MarkJelic/TEC-2014/Display/TEC-2014 Display (PCB Back).JPG

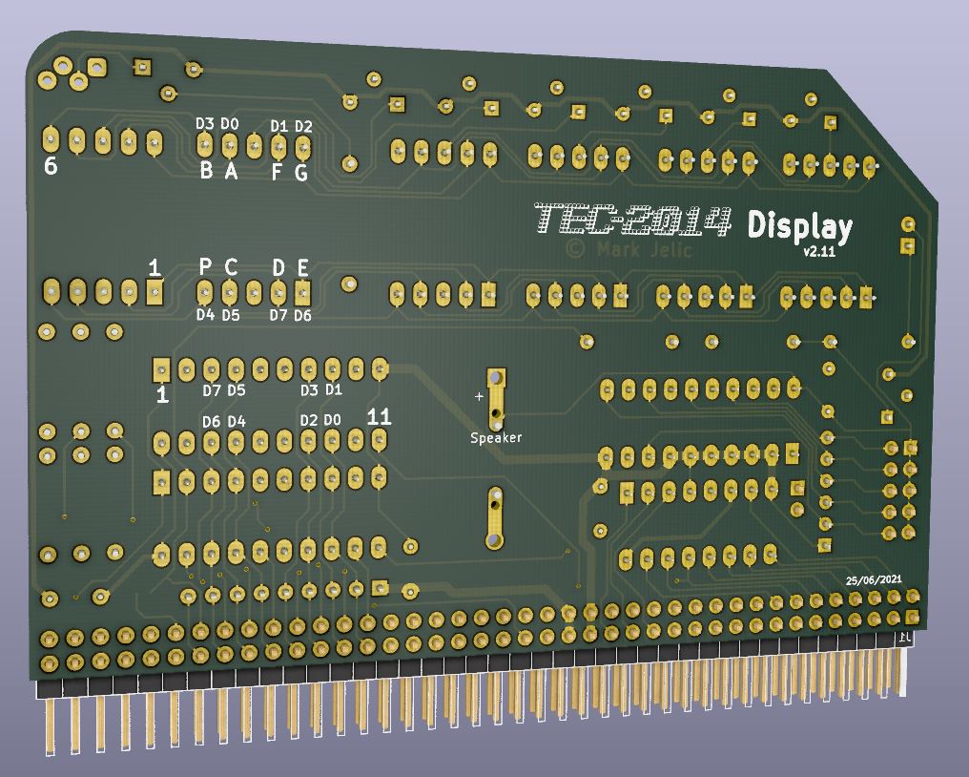
Display/TEC-2014 Display (PCB Back).JPG
