MarkJelic/TEC-2014/SBC/Readme.md

<h1>TEC-2014 Single Board Computer</h1>

Enclosed are all the design files (to date) for the SBC version of the TEC-2014
