MarkJelic/TEC-2014/Memory/Shadow ROM Memory Select Circuit Tester.txt

$ 0 0.000005 10.20027730826997 42 5 50 5e-11
154 -32 96 160 96 0 2 5 5
154 -32 224 160 224 0 2 0 5
154 -32 160 160 160 0 2 5 5
w -32 80 -112 80 0
w 160 192 160 160 0
L -624 -352 -688 -352 0 0 false 5 0
M 304 112 384 112 0 2.5
M 304 208 384 208 0 2.5
w -32 144 -48 144 0
w 160 160 160 128 0
w -112 160 -112 240 0
w -112 240 -32 240 0
w -48 112 -32 112 0
w -48 208 -32 208 0
w -48 144 -48 112 0
w -32 176 -48 176 0
w -48 176 -48 208 0
x -658 -389 -506 -386 4 24 Shadow\sLatch
x -528 356 -475 359 4 24 CS\s1
x -521 75 -468 78 4 24 CS\s8
L -528 -128 -672 -128 0 0 false 5 0
L -528 -96 -672 -96 0 0 false 5 0
x -726 -125 -686 -122 4 24 A11
x -733 -91 -691 -88 4 24 A12
w -112 80 -112 160 0
x -381 352 -283 355 4 24 16k\sRAM
x -419 49 -318 52 4 24 16k\sROM
L -576 -64 -672 -64 0 1 false 5 0
L -512 96 -560 96 0 1 false 5 0
w -176 112 -48 112 0
w -176 208 -48 208 0
155 -624 -352 -560 -352 0 0
x -733 -59 -691 -56 4 24 A13
x -732 -27 -690 -24 4 24 A14
x -733 5 -691 8 4 24 A15
L -608 -32 -672 -32 0 0 false 5 0
L -640 0 -672 0 0 0 false 5 0
w -256 0 -464 0 0
L -624 -320 -688 -320 0 0 false 5 0
184 -672 64 -624 64 3072 3
w -576 -64 -528 -64 0
w -608 -32 -528 -32 0
w -640 0 -528 0 0
151 -256 -16 -112 -16 0 2 0 5
151 160 112 304 112 0 2 0 5
x -519 -330 -404 -327 4 16 LO\s\q\sRom\s@\s2k
x -517 -266 -402 -263 4 16 LO\s\q\sRam\s@\s2k
M -672 320 -720 320 0 2.5
M -528 -352 -480 -352 0 2.5
M -528 -288 -480 -288 0 2.5
x -488 -390 -353 -387 4 16 (On\sReset,\sQ\s\q\sLo)
151 160 208 304 208 0 2 5 5
w -528 -352 -528 -160 0
L -512 128 -560 128 0 1 false 5 0
L -512 160 -560 160 0 1 false 5 0
L -512 192 -560 192 0 1 false 5 0
L -512 224 -560 224 0 1 false 5 0
L -512 256 -560 256 0 1 false 5 0
L -512 288 -560 288 0 0 false 5 0
L -512 320 -560 320 0 1 false 5 0
d -528 0 -464 0 2 default
d -528 -32 -464 -32 2 default
d -528 -64 -464 -64 2 default
d -528 -96 -464 -96 2 default
d -528 -128 -464 -128 2 default
d -528 -160 -464 -160 2 default
r -384 -160 -464 -160 0 10000
g -384 -160 -352 -160 0 0
w -256 0 -256 -32 0
w -576 32 -576 -64 0
w -608 32 -608 -32 0
w -640 32 -640 0 0
w -512 320 -352 320 0
w -512 288 -352 288 0
w -288 288 -288 320 0
w -176 320 -176 208 0
w -512 128 -352 128 0
w -512 96 -352 96 0
w -176 128 -176 112 0
x -434 77 -307 80 4 24 Start\s@\s48k
w -112 -16 -112 80 0
w -464 0 -464 -32 0
w -464 -32 -464 -64 0
w -464 -64 -464 -96 0
w -464 -96 -464 -128 0
w -464 -128 -464 -160 0
d -288 128 -352 128 2 default
d -288 96 -352 96 2 default
d -288 288 -352 288 2 default
d -288 320 -352 320 2 default
w -176 128 -288 128 0
w -288 320 -176 320 0
r -96 320 -176 320 0 10000
r -176 112 -176 64 0 10000
R -96 320 -48 320 0 0 40 5 0 0 0.5
R -176 64 -224 64 0 0 40 5 0 0 0.5
x 269 249 465 252 4 24 ROM\sSelect\s(Low)
x 272 87 465 90 4 24 RAM\sSelect\s(Low)
w -288 96 -288 128 0
