MarkJelic/TEC-2014/SBC/TEC-2014s Schematic.pdf

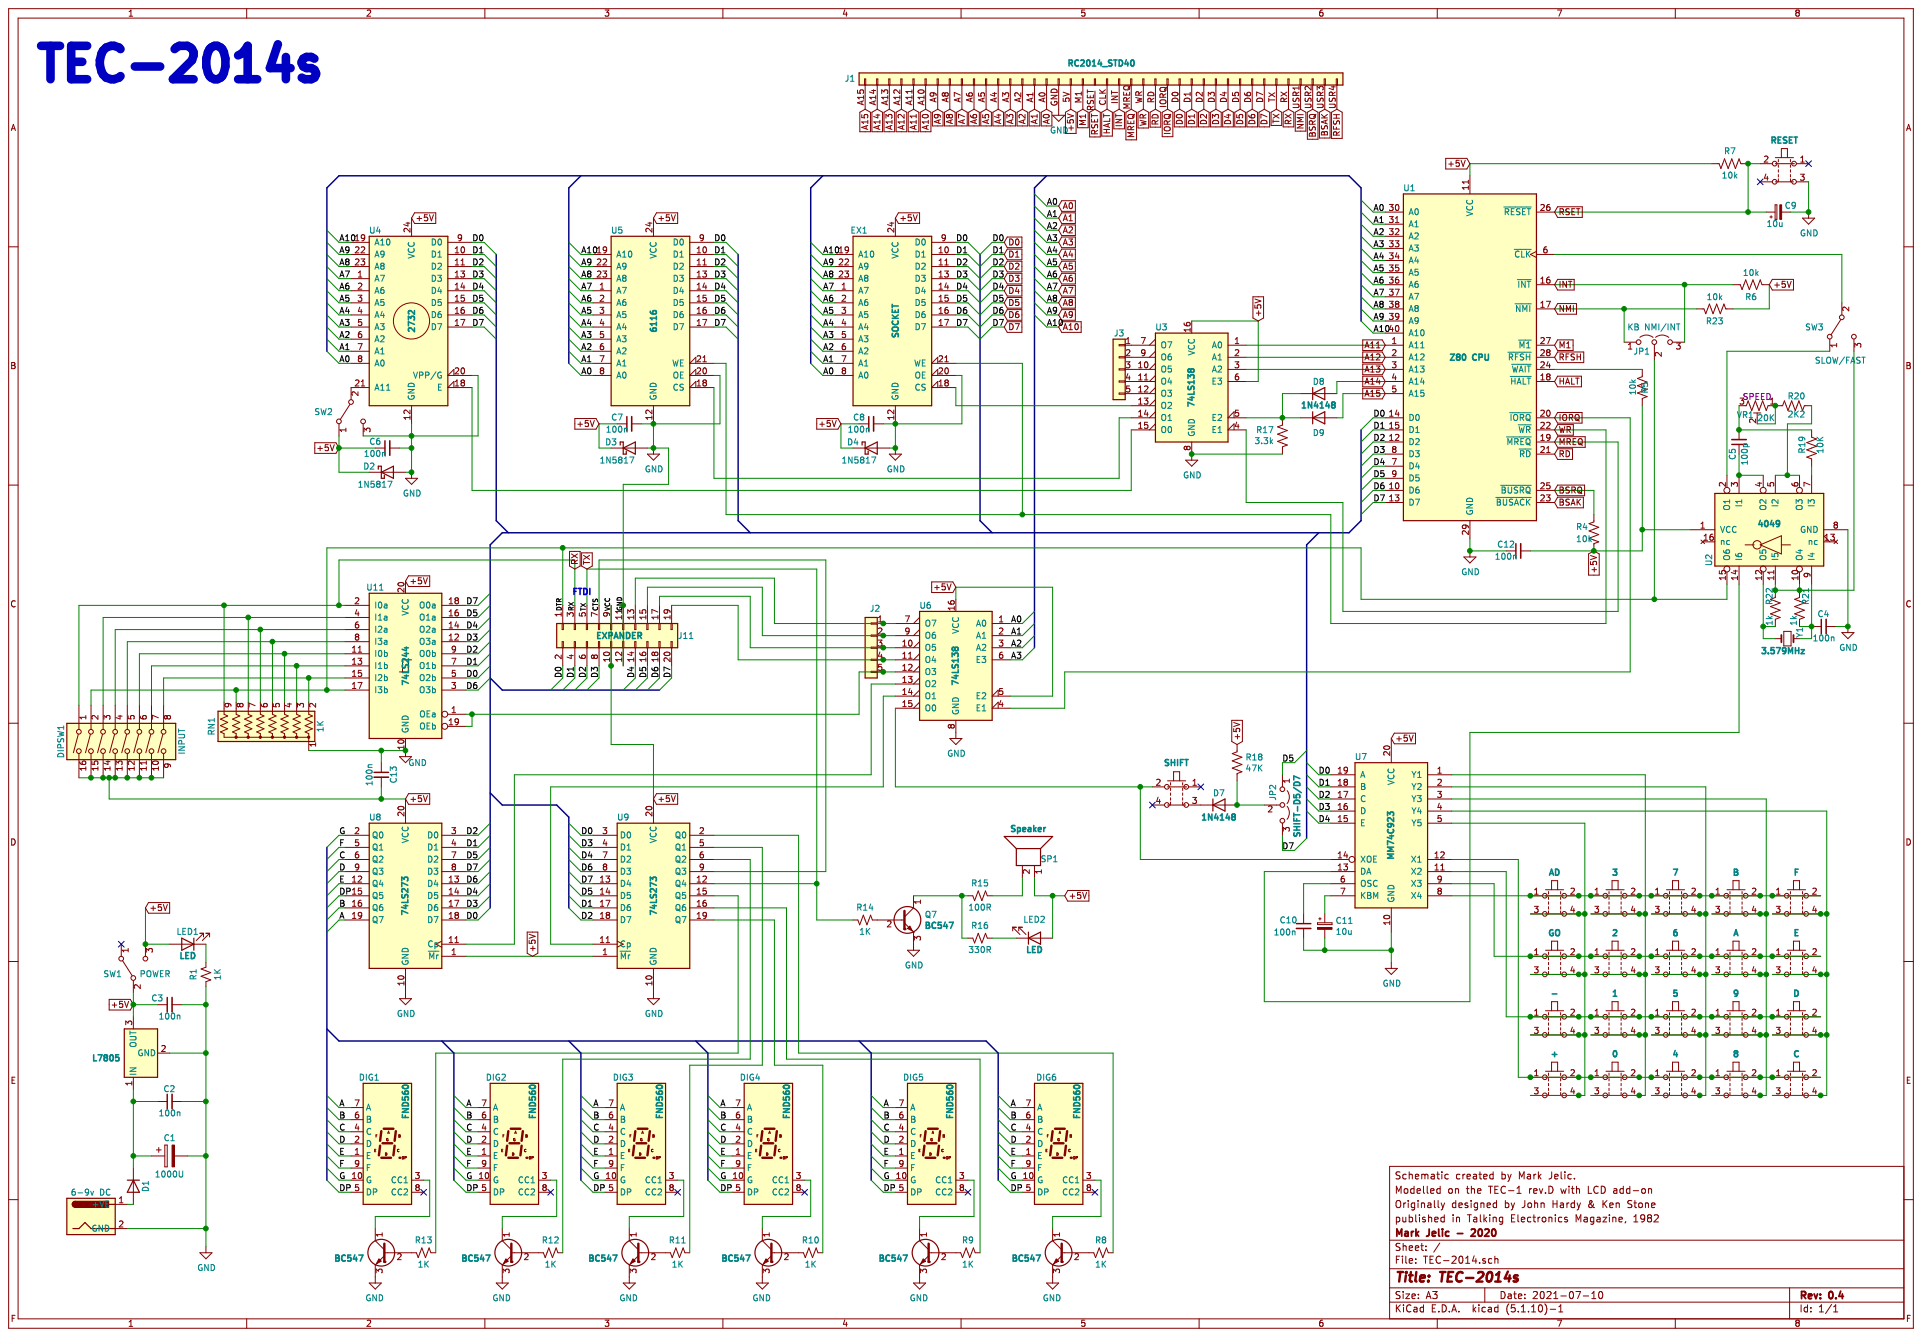
[picture p2: page 1]
