MarkJelic/TEC-2014/Display/TEC-2014 Display v2 Schematic.pdf

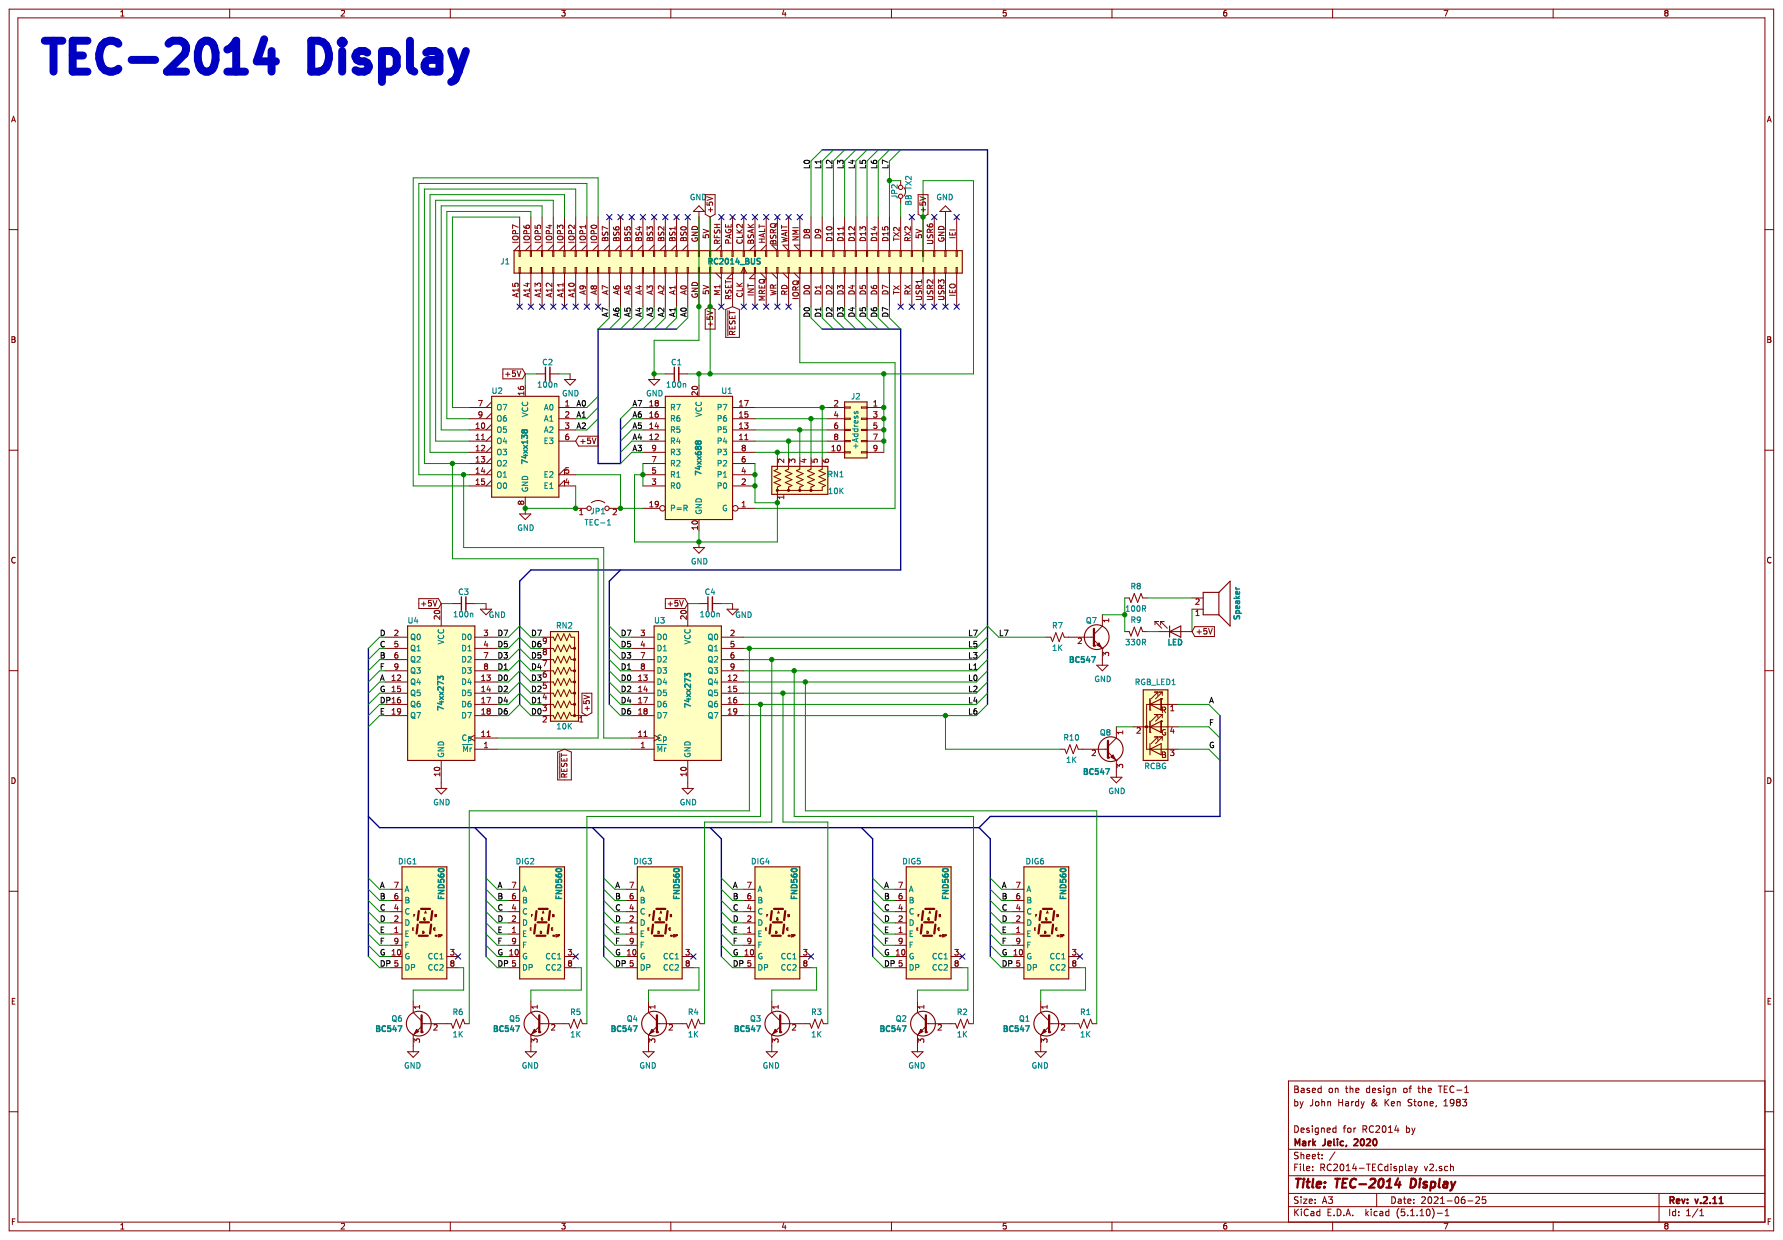
[picture p3: page 1]
