MarkJelic/TEC-2014/Memory/TEC-2014 Memory.pdf

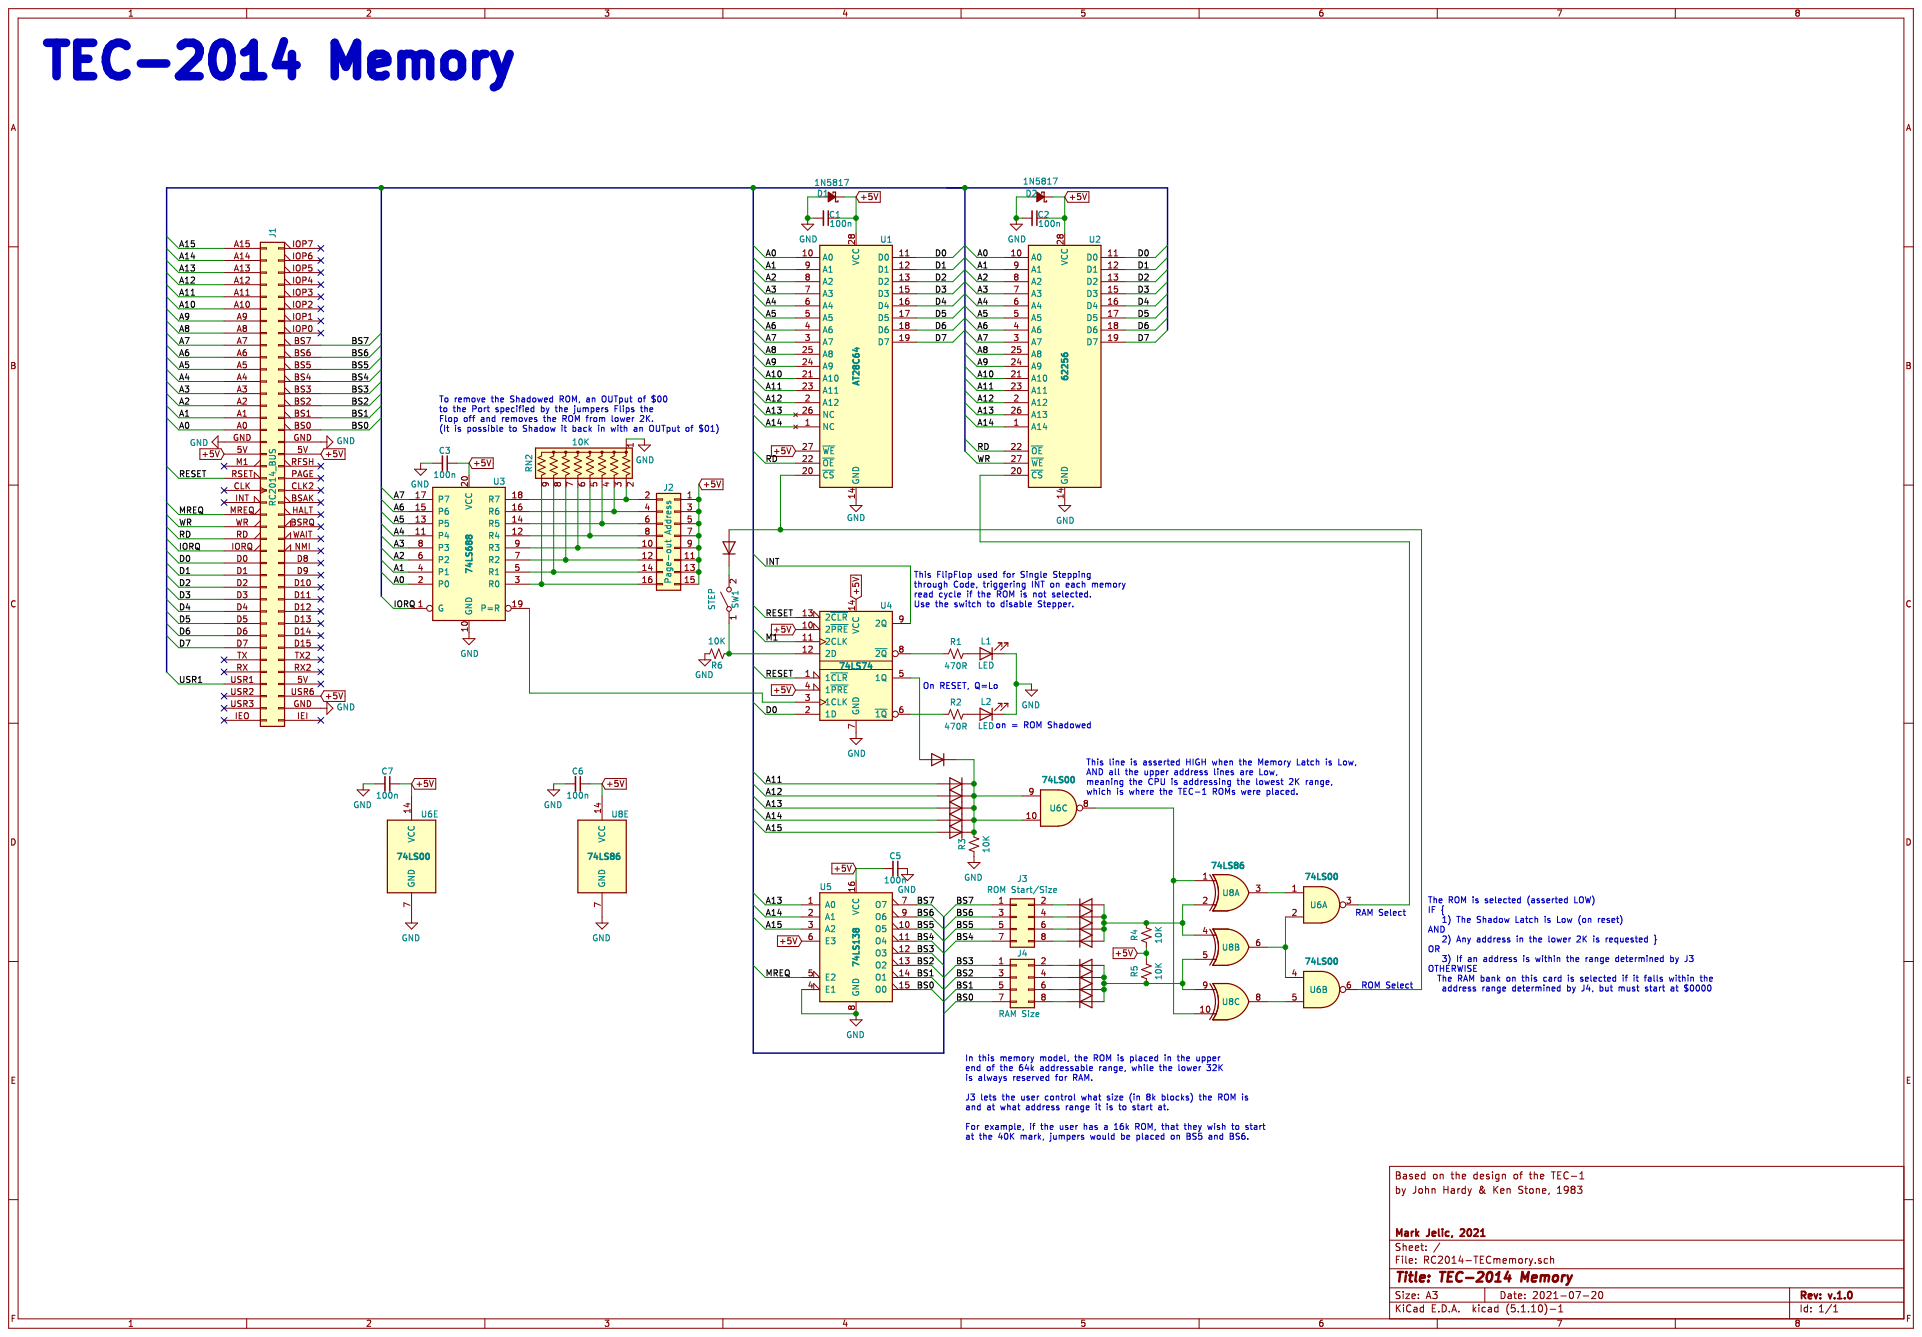
[picture p4: page 1]
