MarkJelic/TEC-2014/Keyboard/TEC-2014 Keyboard.pdf

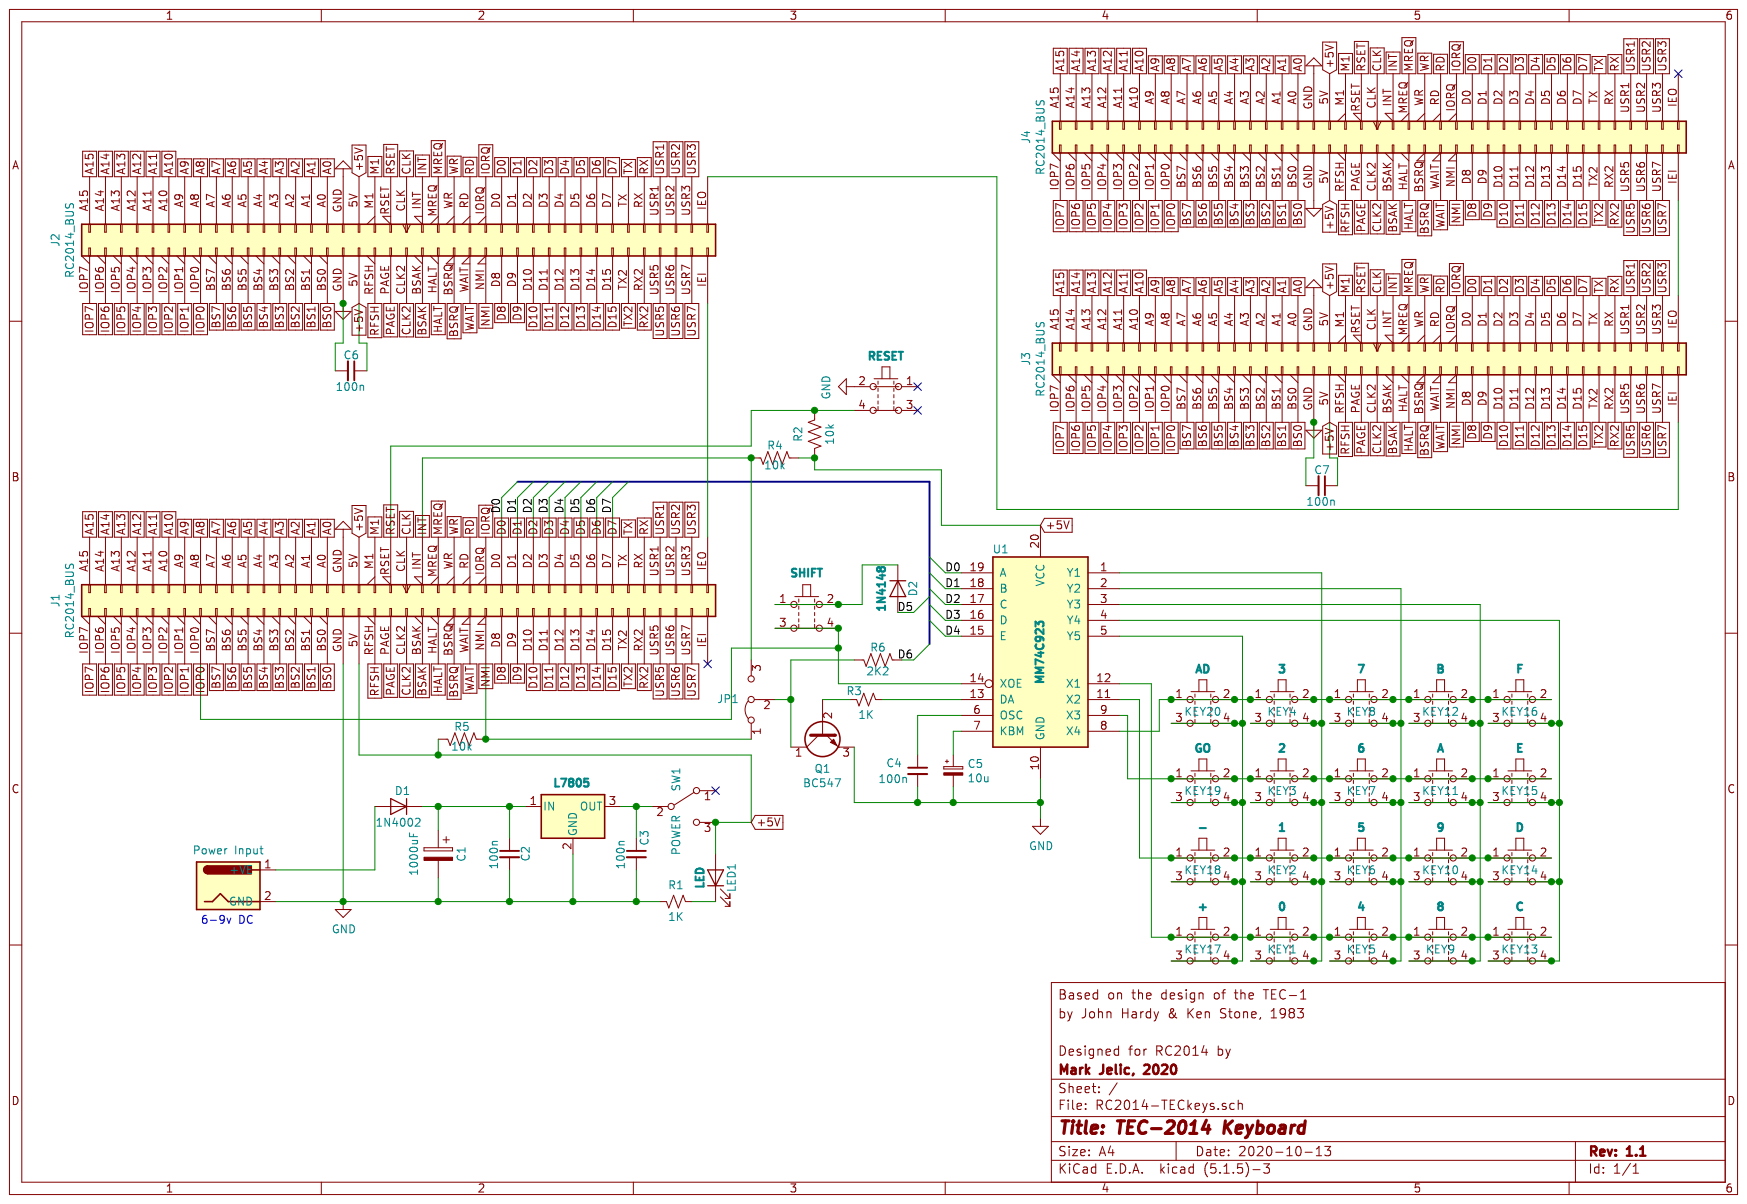
[picture p5: page 1]
