MarkJelic/TEC-2014/Display/RC2014-TECdisplay v2.sch

## KiCad design Display/RC2014-TECdisplay v2.sch (2021-07-03)

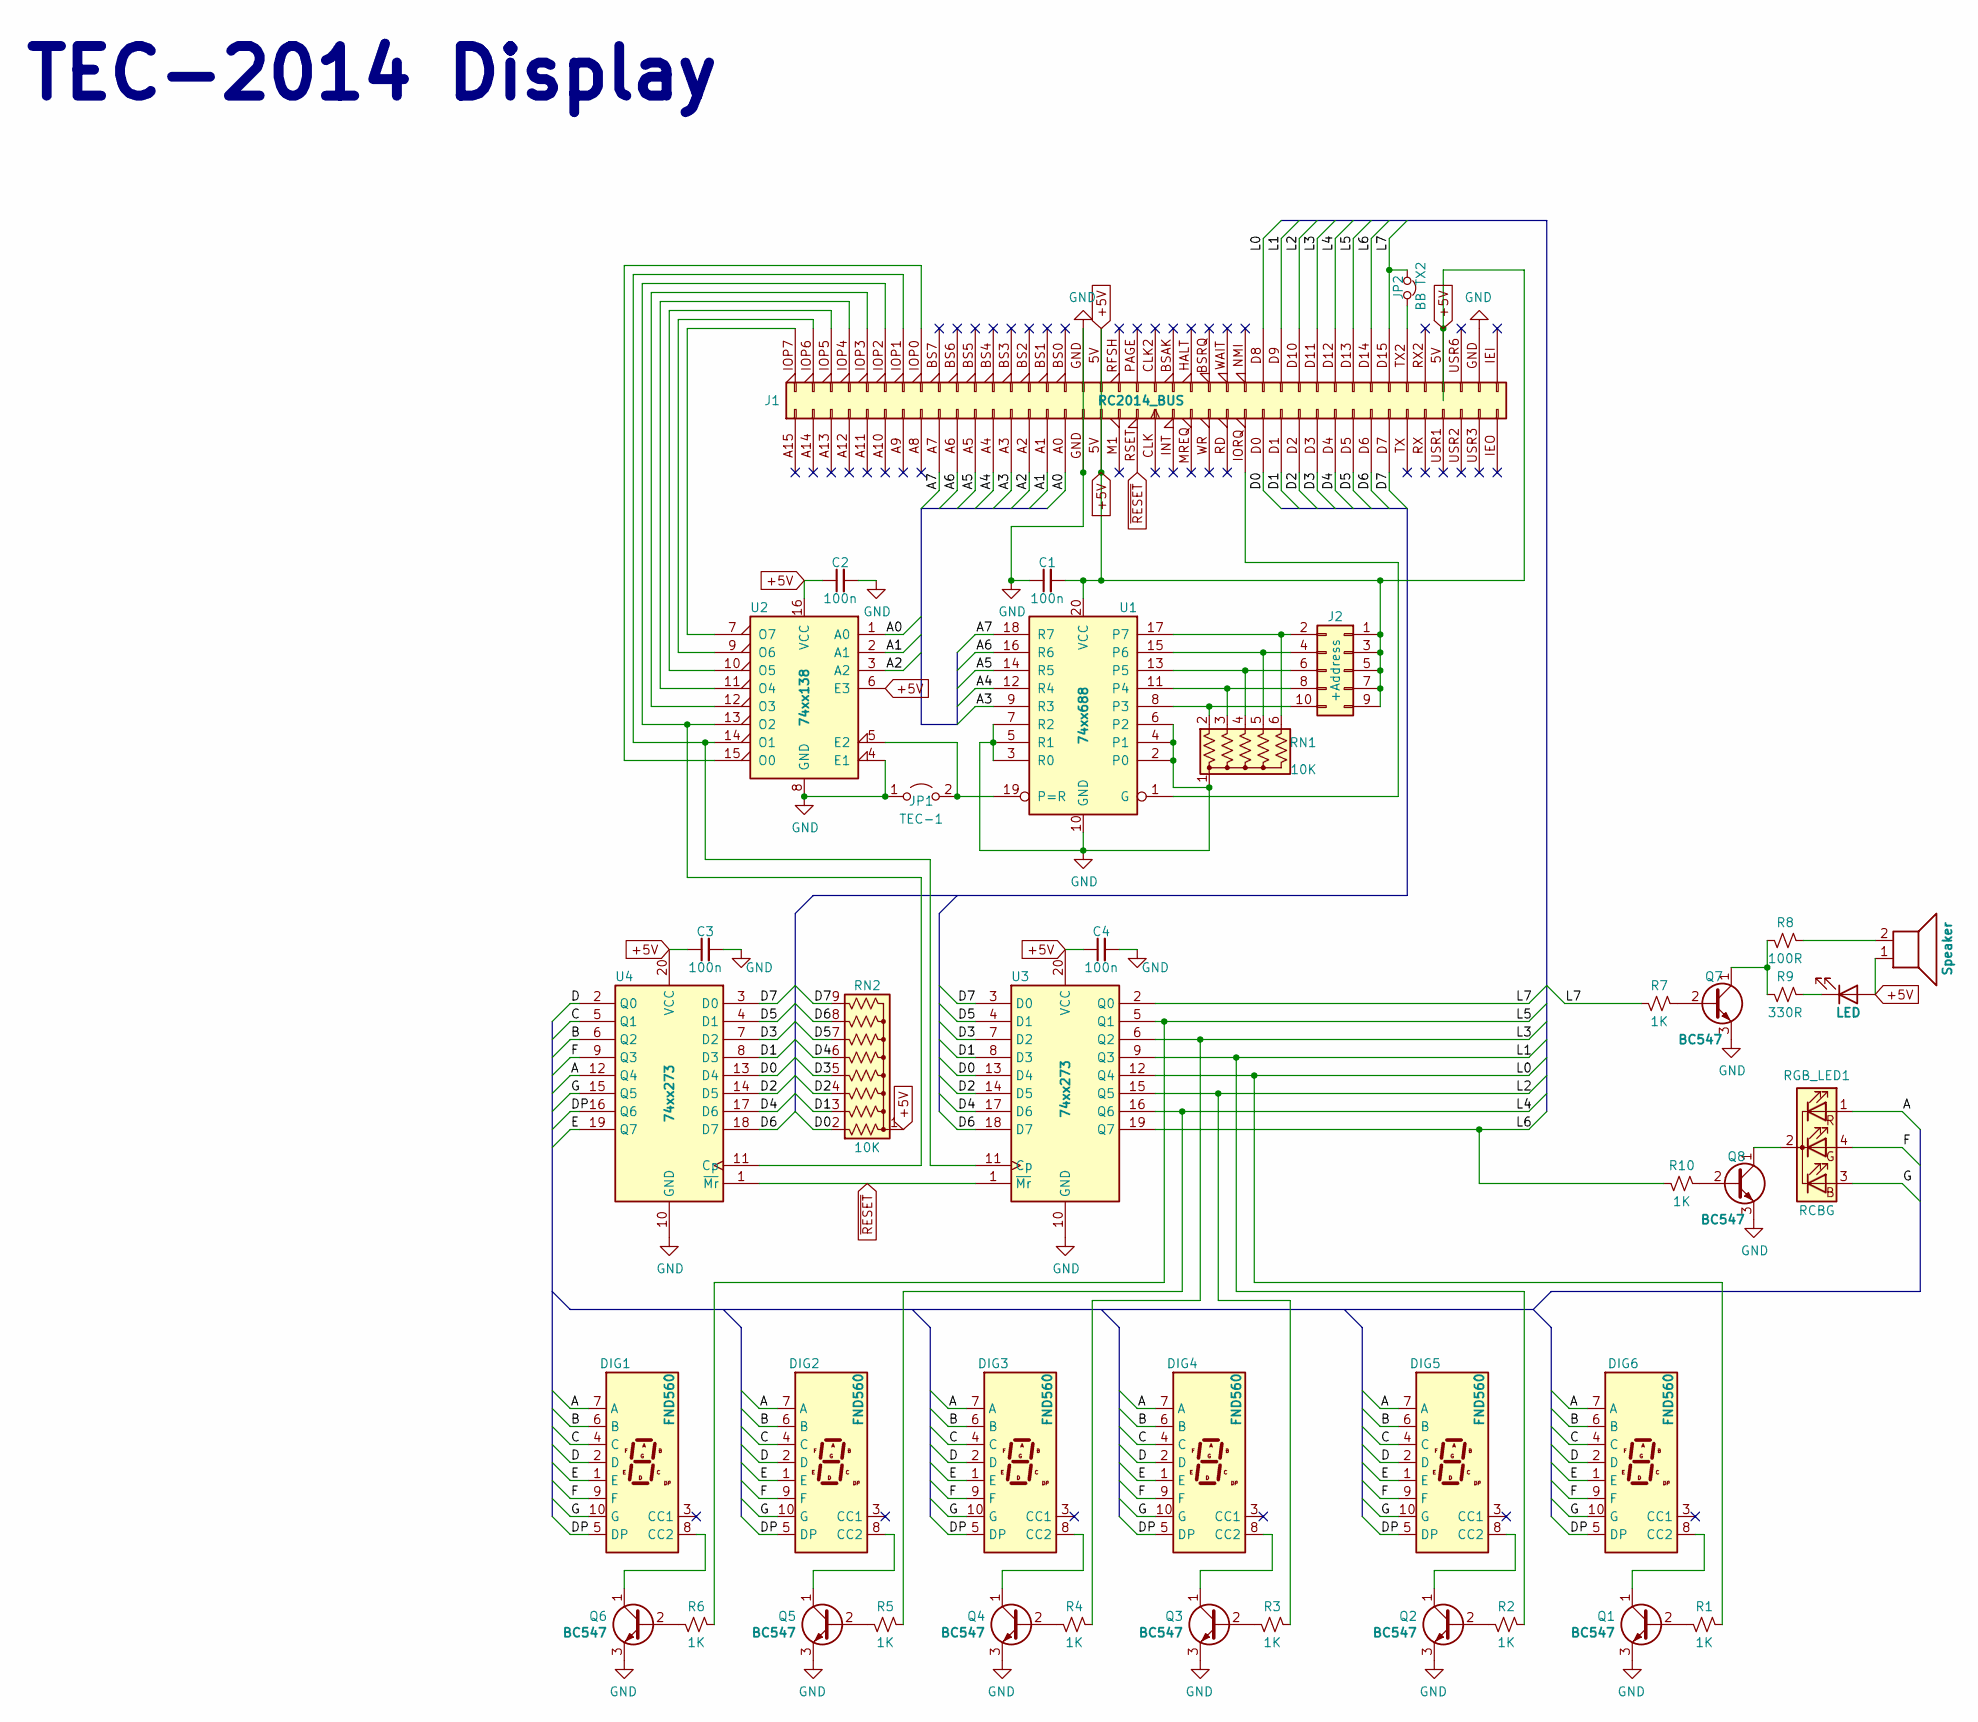
[picture p6: schematic RC2014-TECdisplay v2.sch]

Parts:
C1, C2, C3, C4: 100n; C_Disc_D6.0mm_W2.5mm_P5.00mm
D1: LED; LED_D5.0mm
DIG1, DIG2, DIG3, DIG4, DIG5, DIG6: FND560; 7SegmentLED_LTS6760_LTS6780
J1: RC2014_BUS; RC2014_PinHeader_Horizontal
J2: +Address; PinHeader_2x05_P2.54mm_Vertical
JP1: TEC-1; PinHeader_1x02_P2.54mm_Vertical
JP2: BB TX2; SolderJumper-2_P1.3mm_Bridged_RoundedPad1.0x1.5mm
Q1, Q2, Q3, Q4, Q5, Q6, Q7, Q8: BC547; TO-92L_Wide
R1, R2, R3, R4, R5, R6, R7, R10: 1K; R_Axial_DIN0207_L6.3mm_D2.5mm_P10.16mm_Horizontal
R8: 100R; R_Axial_DIN0207_L6.3mm_D2.5mm_P10.16mm_Horizontal
R9: 330R; R_Axial_DIN0207_L6.3mm_D2.5mm_P10.16mm_Horizontal
RGB_LED1: RCBG; LED_D5.0mm-4_RGB_Staggered_Pins
RN1: 10K; R_Array_SIP6
RN2: 10K; R_Array_SIP9
Speaker1: Speaker; MagneticBuzzer_ProSignal_ABI-010-RC
U1: 74xx688; DIP-20_W7.62mm_LongPads
U2: 74xx138; DIP-16_W7.62mm_LongPads
U3, U4: 74xx273; DIP-20_W7.62mm_LongPads

Connections:
+5V: C1.2, C2.1, C3.1, C4.1, D1.2 (A), J1.5V (Pin_18), J2.1, J2.3, J2.5, J2.7, J2.9, RN2.1 (common), Speaker1.1, U1.20 (VCC), U2.6 (E3), U2.16 (VCC), U3.20 (VCC), U4.20 (VCC)
A: DIG1.7 (A), DIG2.7 (A), DIG3.7 (A), DIG4.7 (A), DIG5.7 (A), DIG6.7 (A), RGB_LED1.1 (RA), U4.12 (Q4)
A0: J1.A0 (Pin_16), U2.1 (A0)
A1: J1.A1 (Pin_15), U2.2 (A1)
A2: J1.A2 (Pin_14), U2.3 (A2)
A3: J1.A3 (Pin_13), U1.9 (R3)
A4: J1.A4 (Pin_12), U1.12 (R4)
A5: J1.A5 (Pin_11), U1.14 (R5)
A6: J1.A6 (Pin_10), U1.16 (R6)
A7: J1.A7 (Pin_9), U1.18 (R7)
B: DIG1.6 (B), DIG2.6 (B), DIG3.6 (B), DIG4.6 (B), DIG5.6 (B), DIG6.6 (B), U4.6 (Q2)
C: DIG1.4 (C), DIG2.4 (C), DIG3.4 (C), DIG4.4 (C), DIG5.4 (C), DIG6.4 (C), U4.5 (Q1)
D: DIG1.2 (D), DIG2.2 (D), DIG3.2 (D), DIG4.2 (D), DIG5.2 (D), DIG6.2 (D), U4.2 (Q0)
D0: J1.D0 (Pin_27), RN2.2 (R1), U3.13 (D4), U4.13 (D4)
D1: J1.D1 (Pin_28), RN2.3 (R2), U3.8 (D3), U4.8 (D3)
D2: J1.D2 (Pin_29), RN2.4 (R3), U3.14 (D5), U4.14 (D5)
D3: J1.D3 (Pin_30), RN2.5 (R4), U3.7 (D2), U4.7 (D2)
D4: J1.D4 (Pin_31), RN2.6 (R5), U3.17 (D6), U4.17 (D6)
D5: J1.D5 (Pin_32), RN2.7 (R6), U3.4 (D1), U4.4 (D1)
D6: J1.D6 (Pin_33), RN2.8 (R7), U3.18 (D7), U4.18 (D7)
D7: J1.D7 (Pin_34), RN2.9 (R8), U3.3 (D0), U4.3 (D0)
DP: DIG1.5 (DP), DIG2.5 (DP), DIG3.5 (DP), DIG4.5 (DP), DIG5.5 (DP), DIG6.5 (DP), U4.16 (Q6)
E: DIG1.1 (E), DIG2.1 (E), DIG3.1 (E), DIG4.1 (E), DIG5.1 (E), DIG6.1 (E), U4.19 (Q7)
F: DIG1.9 (F), DIG2.9 (F), DIG3.9 (F), DIG4.9 (F), DIG5.9 (F), DIG6.9 (F), RGB_LED1.4 (GA), U4.9 (Q3)
G: DIG1.10 (G), DIG2.10 (G), DIG3.10 (G), DIG4.10 (G), DIG5.10 (G), DIG6.10 (G), RGB_LED1.3 (BA), U4.15 (Q5)
GND: C1.1, C2.2, C3.2, C4.2, J1.GND (Pin_17), JP1.1 (A), Q1.3 (E), Q2.3 (E), Q3.3 (E), Q4.3 (E), Q5.3 (E), Q6.3 (E), Q7.3 (E), Q8.3 (E), RN1.1 (common), U1.2 (P0), U1.3 (R0), U1.4 (P1), U1.5 (R1), U1.6 (P2), U1.7 (R2), U1.10 (GND), U2.4 (E1), U2.8 (GND), U3.10 (GND), U4.10 (GND)
L0: J1.D8 (Pin_67), R1.1, U3.12 (Q4)
L1: J1.D9 (Pin_68), R2.1, U3.9 (Q3)
L2: J1.D10 (Pin_69), R3.1, U3.15 (Q5)
L3: J1.D11 (Pin_70), R4.1, U3.6 (Q2)
L4: J1.D12 (Pin_71), R5.1, U3.16 (Q6)
L5: J1.D13 (Pin_72), R6.1, U3.5 (Q1)
L6: J1.D14 (Pin_73), R10.2, U3.19 (Q7)
L7: J1.D15 (Pin_74), JP2.1, R7.2, U3.2 (Q0)
unnamed: D1.1 (K), R9.1
unnamed: DIG1.8 (CC2), Q6.1 (C)
unnamed: DIG2.8 (CC2), Q5.1 (C)
unnamed: DIG3.8 (CC2), Q4.1 (C)
unnamed: DIG4.8 (CC2), Q3.1 (C)
unnamed: DIG5.8 (CC2), Q2.1 (C)
unnamed: DIG6.8 (CC2), Q1.1 (C)
unnamed: J1.IOP0 (Pin_48), U2.15 (O0)
unnamed: J1.IOP1 (Pin_47), U2.14 (O1), U3.11 (Cp)
unnamed: J1.IOP2 (Pin_46), U2.13 (O2), U4.11 (Cp)
unnamed: J1.IOP3 (Pin_45), U2.12 (O3)
unnamed: J1.IOP4 (Pin_44), U2.11 (O4)
unnamed: J1.IOP5 (Pin_43), U2.10 (O5)
unnamed: J1.IOP6 (Pin_42), U2.9 (O6)
unnamed: J1.IOP7 (Pin_41), U2.7 (O7)
unnamed: J1.IORQ (Pin_26), U1.1 (G)
unnamed: J1.TX2 (Pin_75), JP2.2
unnamed: J2.2, RN1.6 (R5), U1.17 (P7)
unnamed: J2.4, RN1.5 (R4), U1.15 (P6)
unnamed: J2.6, RN1.4 (R3), U1.13 (P5)
unnamed: J2.8, RN1.3 (R2), U1.11 (P4)
unnamed: J2.10, RN1.2 (R1), U1.8 (P3)
unnamed: JP1.2 (B), U1.19 (P=R), U2.5 (E2)
unnamed: Q1.2 (B), R1.2
unnamed: Q2.2 (B), R2.2
unnamed: Q3.2 (B), R3.2
unnamed: Q4.2 (B), R4.2
unnamed: Q5.2 (B), R5.2
unnamed: Q6.2 (B), R6.2
unnamed: Q7.1 (C), R8.2, R9.2
unnamed: Q7.2 (B), R7.1
unnamed: Q8.1 (C), RGB_LED1.2 (K)
unnamed: Q8.2 (B), R10.1
unnamed: R8.1, Speaker1.2
~RESET: J1.RSET (Pin_20), U3.1 (~Mr), U4.1 (~Mr)

Notes on the sheet:
TEC-2014 Display
