MarkJelic/TEC-2014/Keyboard/RC2014-TECkeys.sch

## KiCad design Keyboard/RC2014-TECkeys.sch (2021-07-12)

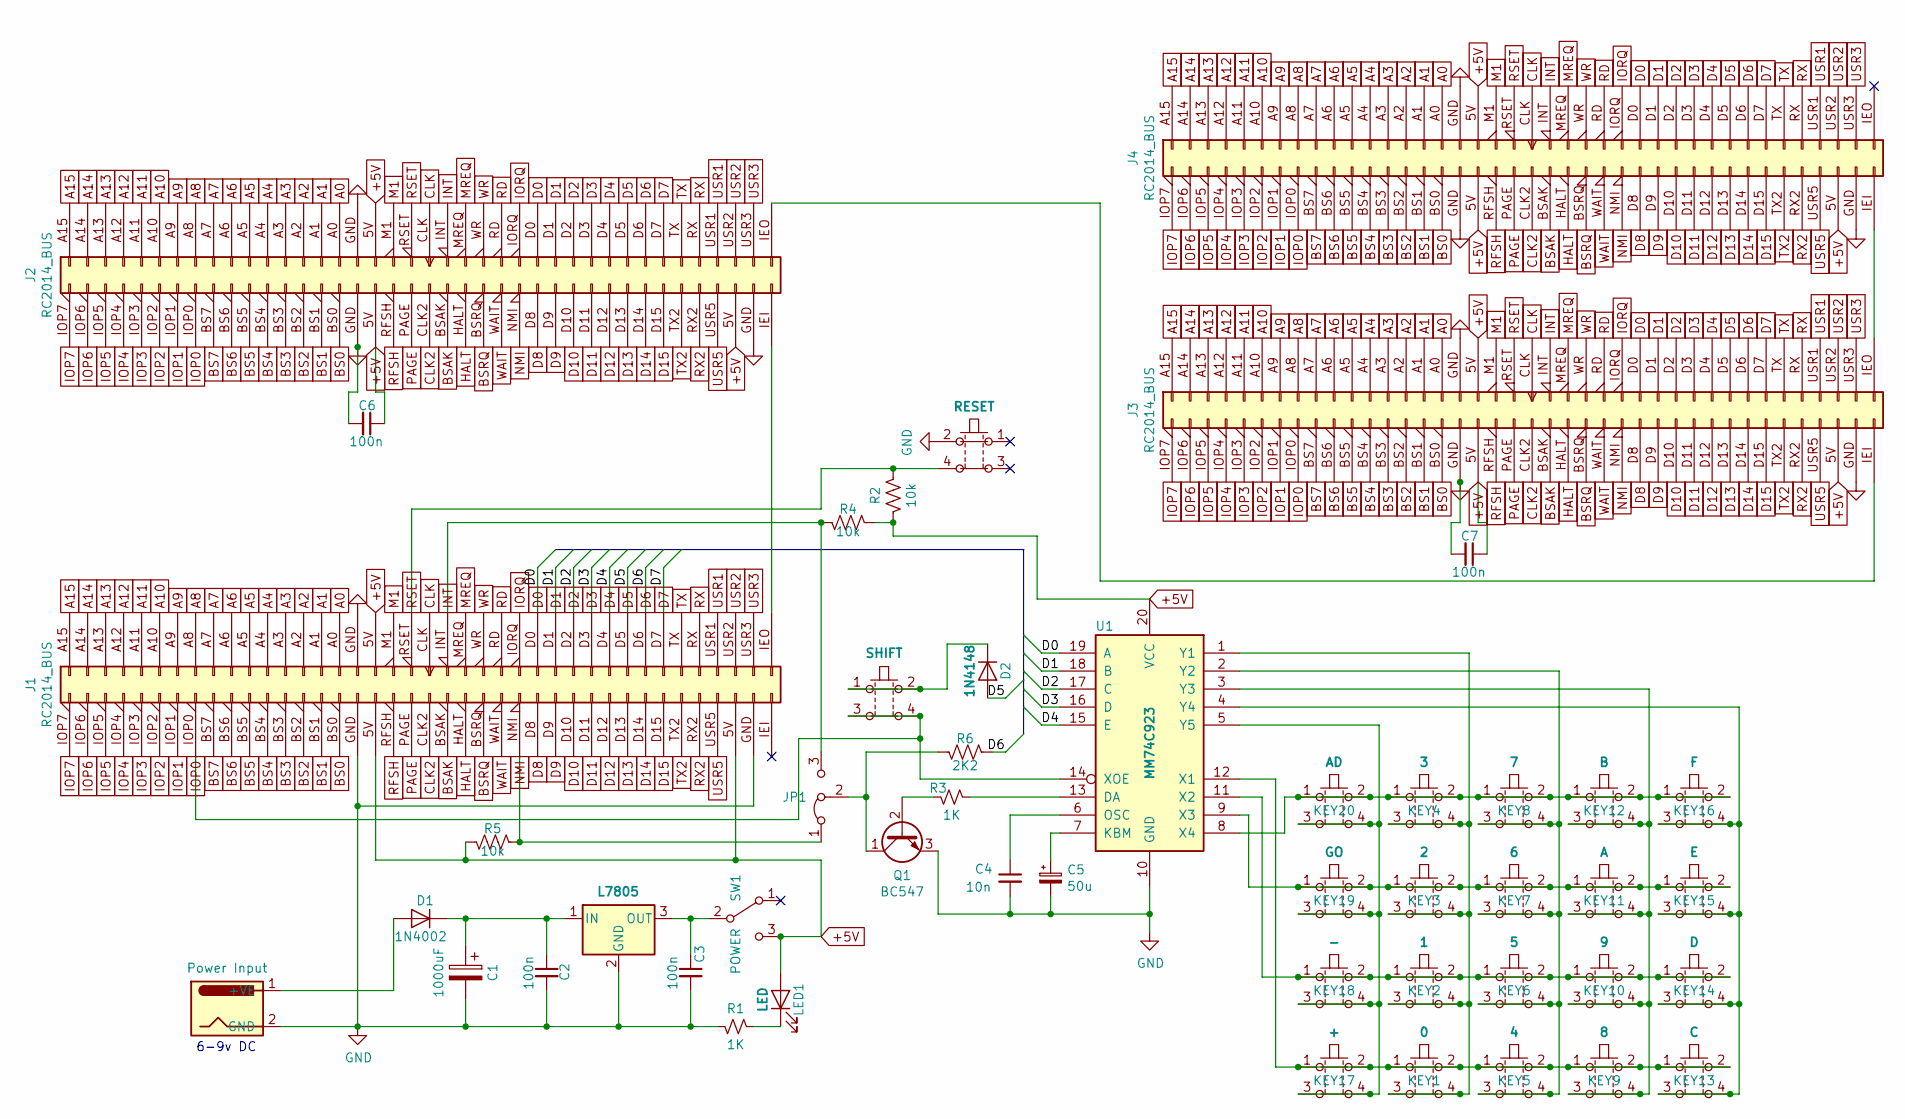
[picture p7: schematic RC2014-TECkeys.sch]

Parts:
C1: 1000uF; CP_Radial_D10.0mm_P5.00mm
C2, C3, C6, C7: 100n; C_Disc_D6.0mm_W2.5mm_P5.00mm
C4: 10n; C_Disc_D6.0mm_W2.5mm_P5.00mm
C5: 50u; CP_Radial_D5.0mm_P2.50mm
D1: 1N4002; D_DO-41_SOD81_P10.16mm_Horizontal
D2: 1N4148; D_DO-35_SOD27_P7.62mm_Horizontal
J1, J2, J3: RC2014_BUS; RC2014_PinSocket_Vertical
J4: RC2014_BUS; RC2014_PinSocket_Horizontal
JP1: NMI/INT; PinHeader_1x03_P2.54mm_Vertical
Jack1: Power Input; BarrelJack_Horizontal
KEY0: RESET; SW_Keyboard_6+12mm
KEY1: 0; SW_Keyboard_6+12mm
KEY2: 1; SW_Keyboard_6+12mm
KEY3: 2; SW_Keyboard_6+12mm
KEY4: 3; SW_Keyboard_6+12mm
KEY5: 4; SW_Keyboard_6+12mm
KEY6: 5; SW_Keyboard_6+12mm
KEY7: 6; SW_Keyboard_6+12mm
KEY8: 7; SW_Keyboard_6+12mm
KEY9: 8; SW_Keyboard_6+12mm
KEY10: 9; SW_Keyboard_6+12mm
KEY11: A; SW_Keyboard_6+12mm
KEY12: B; SW_Keyboard_6+12mm
KEY13: C; SW_Keyboard_6+12mm
KEY14: D; SW_Keyboard_6+12mm
KEY15: E; SW_Keyboard_6+12mm
KEY16: F; SW_Keyboard_6+12mm
KEY17: +; SW_Keyboard_6+12mm
KEY18: -; SW_Keyboard_6+12mm
KEY19: GO; SW_Keyboard_6+12mm
KEY20: AD; SW_Keyboard_6+12mm
KEY21: SHIFT; SW_Keyboard_6+12mm
LED1: LED; LED_D5.0mm
Q1: BC547; TO-92_HandSolder
R1, R3: 1K; R_Axial_DIN0207_L6.3mm_D2.5mm_P10.16mm_Horizontal
R2, R4, R5: 10k; R_Axial_DIN0207_L6.3mm_D2.5mm_P10.16mm_Horizontal
R6: 2K2; R_Axial_DIN0207_L6.3mm_D2.5mm_P10.16mm_Horizontal
REG1: L7805; 7805_Horizontal_TabDwn
SW1: POWER; SW_Slide
U1: MM74C923; DIP-20_W7.62mm_LongPads

Connections:
+5V: C6.1, C7.1, J1.5V (Pin_18), J2.5V (Pin_18), J3.5V (Pin_18), J4.5V (Pin_18), LED1.2 (A), R2.2, R4.1, R5.2, SW1.3 (C), U1.20 (VCC)
A0: J1.A0 (Pin_16), J2.A0 (Pin_16), J3.A0 (Pin_16), J4.A0 (Pin_16)
A1: J1.A1 (Pin_15), J2.A1 (Pin_15), J3.A1 (Pin_15), J4.A1 (Pin_15)
A2: J1.A2 (Pin_14), J2.A2 (Pin_14), J3.A2 (Pin_14), J4.A2 (Pin_14)
A3: J1.A3 (Pin_13), J2.A3 (Pin_13), J3.A3 (Pin_13), J4.A3 (Pin_13)
A4: J1.A4 (Pin_12), J2.A4 (Pin_12), J3.A4 (Pin_12), J4.A4 (Pin_12)
A5: J1.A5 (Pin_11), J2.A5 (Pin_11), J3.A5 (Pin_11), J4.A5 (Pin_11)
A6: J1.A6 (Pin_10), J2.A6 (Pin_10), J3.A6 (Pin_10), J4.A6 (Pin_10)
A7: J1.A7 (Pin_9), J2.A7 (Pin_9), J3.A7 (Pin_9), J4.A7 (Pin_9)
A8: J1.A8 (Pin_8), J2.A8 (Pin_8), J3.A8 (Pin_8), J4.A8 (Pin_8)
A9: J1.A9 (Pin_7), J2.A9 (Pin_7), J3.A9 (Pin_7), J4.A9 (Pin_7)
A10: J1.A10 (Pin_6), J2.A10 (Pin_6), J3.A10 (Pin_6), J4.A10 (Pin_6)
A11: J1.A11 (Pin_5), J2.A11 (Pin_5), J3.A11 (Pin_5), J4.A11 (Pin_5)
A12: J1.A12 (Pin_4), J2.A12 (Pin_4), J3.A12 (Pin_4), J4.A12 (Pin_4)
A13: J1.A13 (Pin_3), J2.A13 (Pin_3), J3.A13 (Pin_3), J4.A13 (Pin_3)
A14: J1.A14 (Pin_2), J2.A14 (Pin_2), J3.A14 (Pin_2), J4.A14 (Pin_2)
A15: J1.A15 (Pin_1), J2.A15 (Pin_1), J3.A15 (Pin_1), J4.A15 (Pin_1)
BS0: J1.BS0 (Pin_56), J2.BS0 (Pin_56), J3.BS0 (Pin_56), J4.BS0 (Pin_56)
BS1: J1.BS1 (Pin_55), J2.BS1 (Pin_55), J3.BS1 (Pin_55), J4.BS1 (Pin_55)
BS2: J1.BS2 (Pin_54), J2.BS2 (Pin_54), J3.BS2 (Pin_54), J4.BS2 (Pin_54)
BS3: J1.BS3 (Pin_53), J2.BS3 (Pin_53), J3.BS3 (Pin_53), J4.BS3 (Pin_53)
BS4: J1.BS4 (Pin_52), J2.BS4 (Pin_52), J3.BS4 (Pin_52), J4.BS4 (Pin_52)
BS5: J1.BS5 (Pin_51), J2.BS5 (Pin_51), J3.BS5 (Pin_51), J4.BS5 (Pin_51)
BS6: J1.BS6 (Pin_50), J2.BS6 (Pin_50), J3.BS6 (Pin_50), J4.BS6 (Pin_50)
BS7: J1.BS7 (Pin_49), J2.BS7 (Pin_49), J3.BS7 (Pin_49), J4.BS7 (Pin_49)
BSAK: J1.BSAK (Pin_62), J2.BSAK (Pin_62), J3.BSAK (Pin_62), J4.BSAK (Pin_62)
BSRQ: J1.BSRQ (Pin_64), J2.BSRQ (Pin_64), J3.BSRQ (Pin_64), J4.BSRQ (Pin_64)
CLK: J1.CLK (Pin_21), J2.CLK (Pin_21), J3.CLK (Pin_21), J4.CLK (Pin_21)
CLK2: J1.CLK2 (Pin_61), J2.CLK2 (Pin_61), J3.CLK2 (Pin_61), J4.CLK2 (Pin_61)
D0: J1.D0 (Pin_27), J2.D0 (Pin_27), J3.D0 (Pin_27), J4.D0 (Pin_27), U1.19 (A)
D1: J1.D1 (Pin_28), J2.D1 (Pin_28), J3.D1 (Pin_28), J4.D1 (Pin_28), U1.18 (B)
D2: J1.D2 (Pin_29), J2.D2 (Pin_29), J3.D2 (Pin_29), J4.D2 (Pin_29), U1.17 (C)
D3: J1.D3 (Pin_30), J2.D3 (Pin_30), J3.D3 (Pin_30), J4.D3 (Pin_30), U1.16 (D)
D4: J1.D4 (Pin_31), J2.D4 (Pin_31), J3.D4 (Pin_31), J4.D4 (Pin_31), U1.15 (E)
D5: D2.2 (A), J1.D5 (Pin_32), J2.D5 (Pin_32), J3.D5 (Pin_32), J4.D5 (Pin_32)
D6: J1.D6 (Pin_33), J2.D6 (Pin_33), J3.D6 (Pin_33), J4.D6 (Pin_33), R6.1
D7: J1.D7 (Pin_34), J2.D7 (Pin_34), J3.D7 (Pin_34), J4.D7 (Pin_34)
D8: J1.D8 (Pin_67), J2.D8 (Pin_67), J3.D8 (Pin_67), J4.D8 (Pin_67)
D9: J1.D9 (Pin_68), J2.D9 (Pin_68), J3.D9 (Pin_68), J4.D9 (Pin_68)
D10: J1.D10 (Pin_69), J2.D10 (Pin_69), J3.D10 (Pin_69), J4.D10 (Pin_69)
D11: J1.D11 (Pin_70), J2.D11 (Pin_70), J3.D11 (Pin_70), J4.D11 (Pin_70)
D12: J1.D12 (Pin_71), J2.D12 (Pin_71), J3.D12 (Pin_71), J4.D12 (Pin_71)
D13: J1.D13 (Pin_72), J2.D13 (Pin_72), J3.D13 (Pin_72), J4.D13 (Pin_72)
D14: J1.D14 (Pin_73), J2.D14 (Pin_73), J3.D14 (Pin_73), J4.D14 (Pin_73)
D15: J1.D15 (Pin_74), J2.D15 (Pin_74), J3.D15 (Pin_74), J4.D15 (Pin_74)
GND: C1.2, C2.2, C3.2, C4.2, C5.2, C6.2, C7.2, J1.GND (Pin_17), J2.GND (Pin_17), J3.GND (Pin_17), J4.GND (Pin_17), Jack1.2 (GND), KEY0.2, Q1.3 (E), R1.2, REG1.2 (GND), U1.10 (GND)
HALT: J1.HALT (Pin_63), J2.HALT (Pin_63), J3.HALT (Pin_63), J4.HALT (Pin_63)
INT: J1.INT (Pin_22), J2.INT (Pin_22), J3.INT (Pin_22), J4.INT (Pin_22), JP1.3 (B), R4.2
IOP0: J1.IOP0 (Pin_48), J2.IOP0 (Pin_48), J3.IOP0 (Pin_48), J4.IOP0 (Pin_48), KEY21.3, KEY21.4, U1.14 (XOE)
IOP1: J1.IOP1 (Pin_47), J2.IOP1 (Pin_47), J3.IOP1 (Pin_47), J4.IOP1 (Pin_47)
IOP2: J1.IOP2 (Pin_46), J2.IOP2 (Pin_46), J3.IOP2 (Pin_46), J4.IOP2 (Pin_46)
IOP3: J1.IOP3 (Pin_45), J2.IOP3 (Pin_45), J3.IOP3 (Pin_45), J4.IOP3 (Pin_45)
IOP4: J1.IOP4 (Pin_44), J2.IOP4 (Pin_44), J3.IOP4 (Pin_44), J4.IOP4 (Pin_44)
IOP5: J1.IOP5 (Pin_43), J2.IOP5 (Pin_43), J3.IOP5 (Pin_43), J4.IOP5 (Pin_43)
IOP6: J1.IOP6 (Pin_42), J2.IOP6 (Pin_42), J3.IOP6 (Pin_42), J4.IOP6 (Pin_42)
IOP7: J1.IOP7 (Pin_41), J2.IOP7 (Pin_41), J3.IOP7 (Pin_41), J4.IOP7 (Pin_41)
IORQ: J1.IORQ (Pin_26), J2.IORQ (Pin_26), J3.IORQ (Pin_26), J4.IORQ (Pin_26)
M1: J1.M1 (Pin_19), J2.M1 (Pin_19), J3.M1 (Pin_19), J4.M1 (Pin_19)
MREQ: J1.MREQ (Pin_23), J2.MREQ (Pin_23), J3.MREQ (Pin_23), J4.MREQ (Pin_23)
NMI: J1.NMI (Pin_66), J2.NMI (Pin_66), J3.NMI (Pin_66), J4.NMI (Pin_66), JP1.1 (A), R5.1
unnamed: C1.1, C2.1, D1.1 (K), REG1.1 (IN)
unnamed: C3.1, REG1.3 (OUT), SW1.2 (B)
unnamed: C4.1, U1.6 (OSC)
unnamed: C5.1, U1.7 (KBM)
unnamed: D1.2 (A), Jack1.1 (+VE)
unnamed: D2.1 (K), KEY21.1, KEY21.2
unnamed: J1.IEO (Pin_40), J2.IEI (Pin_80)
unnamed: J2.IEO (Pin_40), J3.IEI (Pin_80)
unnamed: J3.IEO (Pin_40), J4.IEI (Pin_80)
unnamed: JP1.2 (C), Q1.1 (C), R6.2
unnamed: KEY1.1, KEY1.2, KEY5.1, KEY5.2, KEY9.1, KEY9.2, KEY13.1, KEY13.2, KEY17.1, KEY17.2, U1.12 (X1)
unnamed: KEY1.3, KEY1.4, KEY2.3, KEY2.4, KEY3.3, KEY3.4, KEY4.3, KEY4.4, U1.1 (Y1)
unnamed: KEY5.3, KEY5.4, KEY6.3, KEY6.4, KEY7.3, KEY7.4, KEY8.3, KEY8.4, U1.2 (Y2)
unnamed: KEY2.1, KEY2.2, KEY6.1, KEY6.2, KEY10.1, KEY10.2, KEY14.1, KEY14.2, KEY18.1, KEY18.2, U1.11 (X2)
unnamed: KEY9.3, KEY9.4, KEY10.3, KEY10.4, KEY11.3, KEY11.4, KEY12.3, KEY12.4, U1.3 (Y3)
unnamed: KEY3.1, KEY3.2, KEY7.1, KEY7.2, KEY11.1, KEY11.2, KEY15.1, KEY15.2, KEY19.1, KEY19.2, U1.9 (X3)
unnamed: KEY4.1, KEY4.2, KEY8.1, KEY8.2, KEY12.1, KEY12.2, KEY16.1, KEY16.2, KEY20.1, KEY20.2, U1.8 (X4)
unnamed: KEY13.3, KEY13.4, KEY14.3, KEY14.4, KEY15.3, KEY15.4, KEY16.3, KEY16.4, U1.4 (Y4)
unnamed: KEY17.3, KEY17.4, KEY18.3, KEY18.4, KEY19.3, KEY19.4, KEY20.3, KEY20.4, U1.5 (Y5)
unnamed: LED1.1 (K), R1.1
unnamed: Q1.2 (B), R3.2
unnamed: R3.1, U1.13 (DA)
PAGE: J1.PAGE (Pin_60), J2.PAGE (Pin_60), J3.PAGE (Pin_60), J4.PAGE (Pin_60)
RD: J1.RD (Pin_25), J2.RD (Pin_25), J3.RD (Pin_25), J4.RD (Pin_25)
RFSH: J1.RFSH (Pin_59), J2.RFSH (Pin_59), J3.RFSH (Pin_59), J4.RFSH (Pin_59)
RSET: J1.RSET (Pin_20), J2.RSET (Pin_20), J3.RSET (Pin_20), J4.RSET (Pin_20), KEY0.4, R2.1
RX: J1.RX (Pin_36), J2.RX (Pin_36), J3.RX (Pin_36), J4.RX (Pin_36)
RX2: J1.RX2 (Pin_76), J2.RX2 (Pin_76), J3.RX2 (Pin_76), J4.RX2 (Pin_76)
TX: J1.TX (Pin_35), J2.TX (Pin_35), J3.TX (Pin_35), J4.TX (Pin_35)
TX2: J1.TX2 (Pin_75), J2.TX2 (Pin_75), J3.TX2 (Pin_75), J4.TX2 (Pin_75)
USR1: J1.USR1 (Pin_37), J2.USR1 (Pin_37), J3.USR1 (Pin_37), J4.USR1 (Pin_37)
USR2: J1.USR2 (Pin_38), J2.USR2 (Pin_38), J3.USR2 (Pin_38), J4.USR2 (Pin_38)
USR3: J1.USR3 (Pin_39), J2.USR3 (Pin_39), J3.USR3 (Pin_39), J4.USR3 (Pin_39)
USR5: J1.USR5 (Pin_77), J2.USR5 (Pin_77), J3.USR5 (Pin_77), J4.USR5 (Pin_77)
WAIT: J1.WAIT (Pin_65), J2.WAIT (Pin_65), J3.WAIT (Pin_65), J4.WAIT (Pin_65)
WR: J1.WR (Pin_24), J2.WR (Pin_24), J3.WR (Pin_24), J4.WR (Pin_24)

Notes on the sheet:
6-9v DC
