MarkJelic/TEC-2014/Memory/RC2014-TECmemory.sch

## KiCad design Memory/RC2014-TECmemory.sch (2021-07-20)

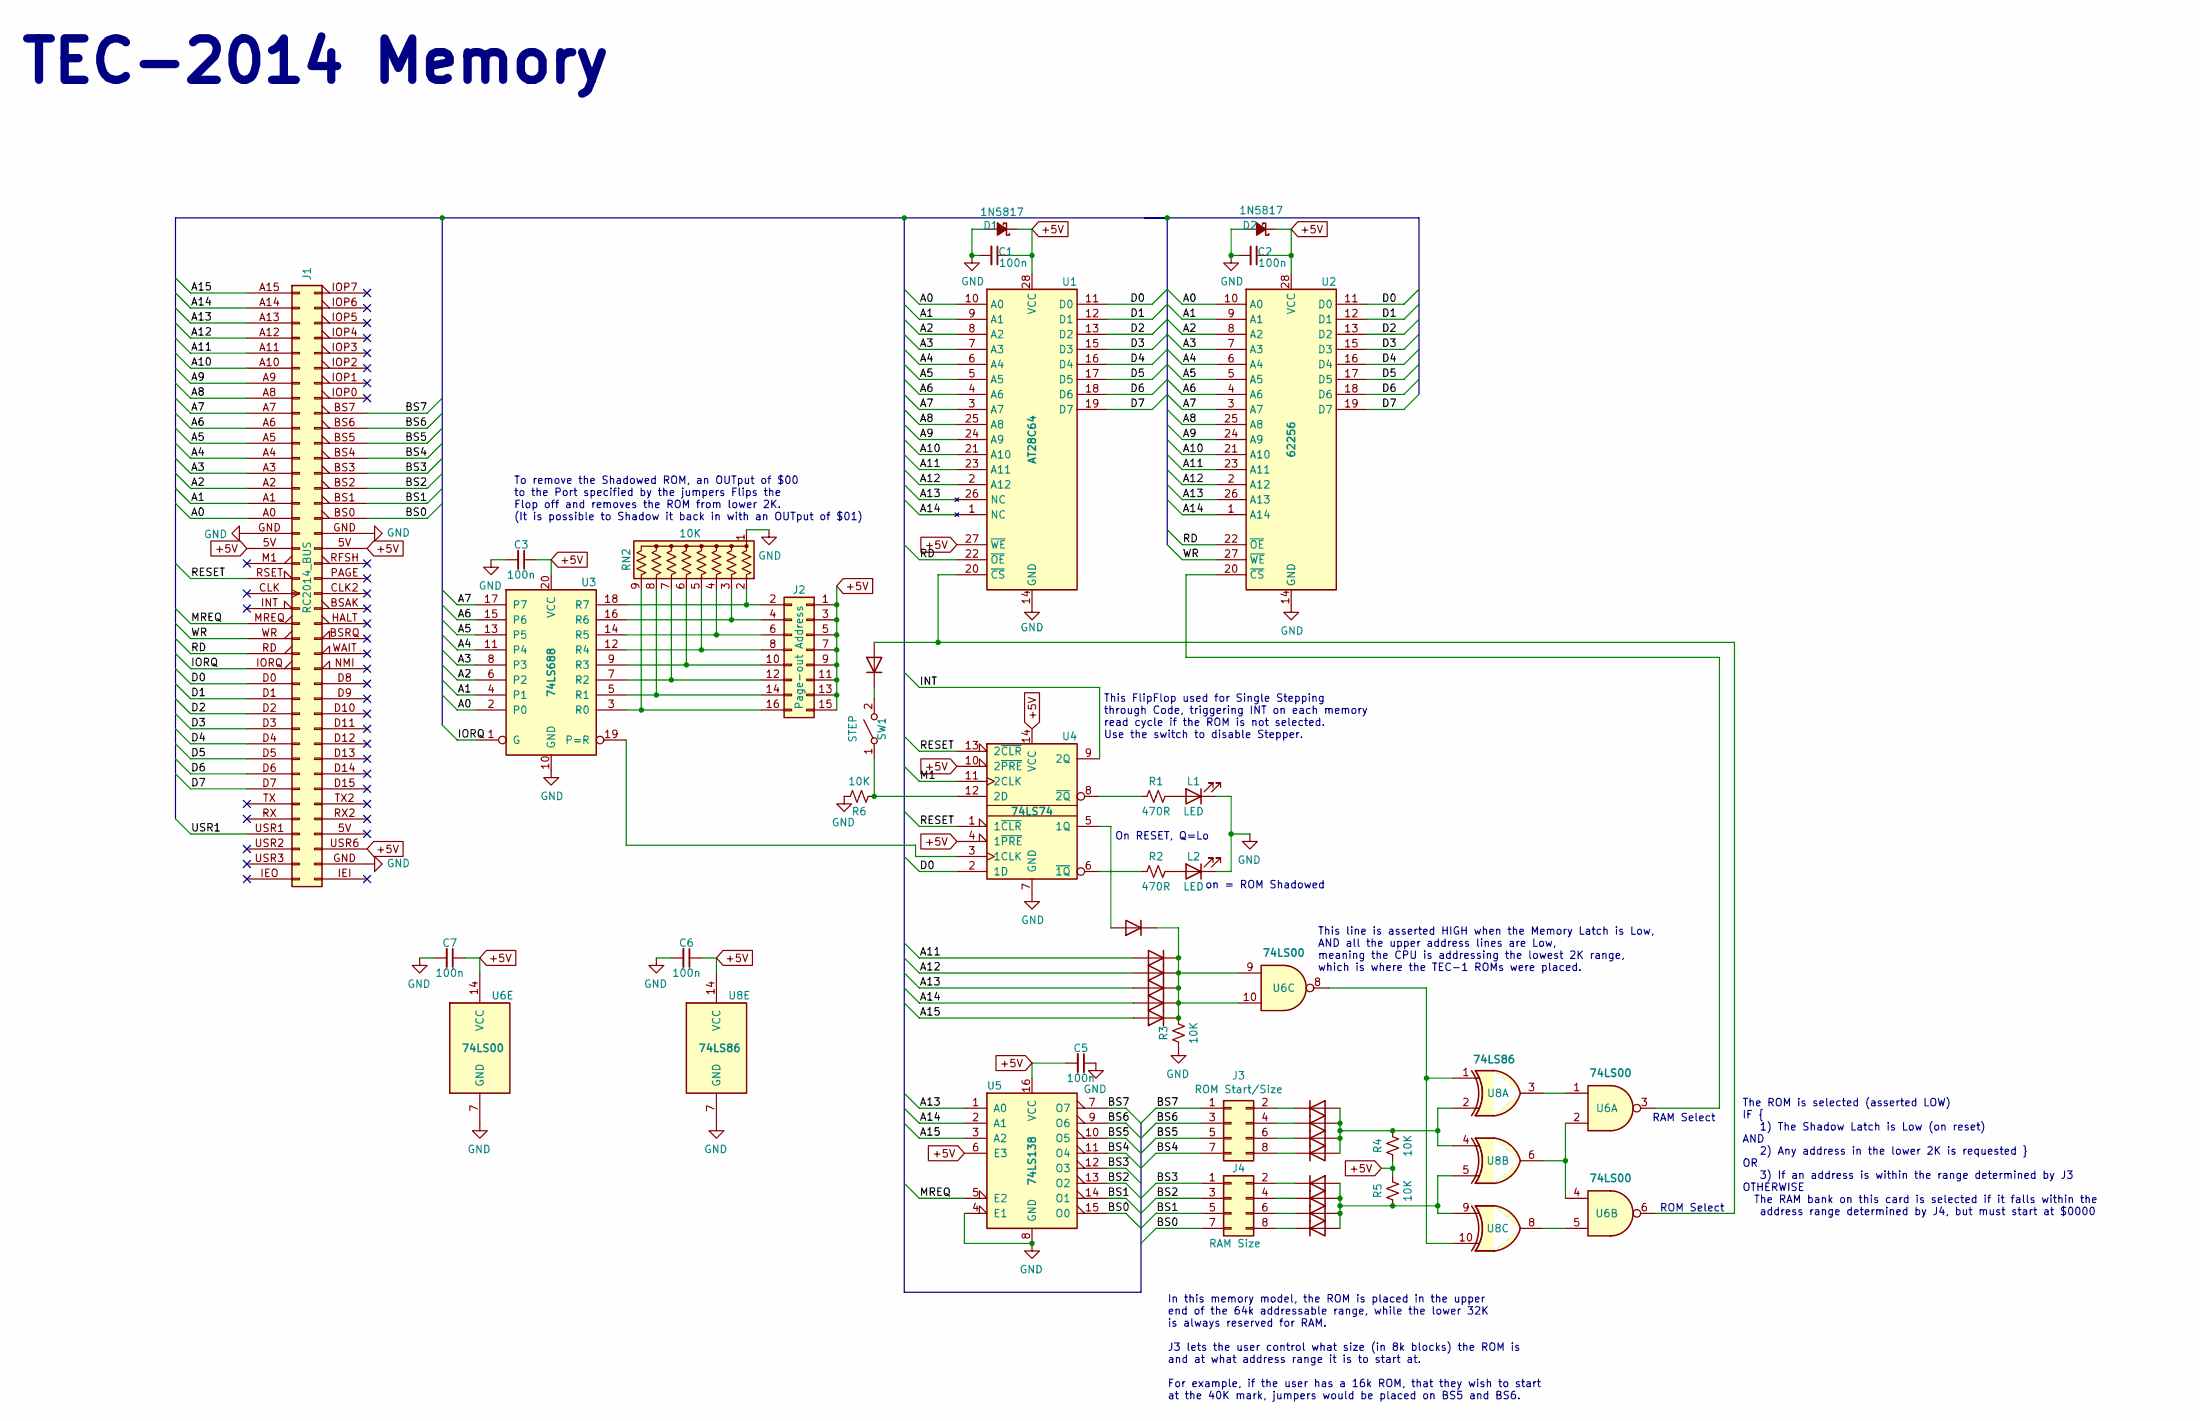
[picture p8: schematic RC2014-TECmemory.sch]

Parts:
C1, C2, C3, C5, C6, C7: 100n; C_Disc_D6.0mm_W2.5mm_P5.00mm
D1, D2: 1N5817; D_DO-35_SOD27_P7.62mm_Horizontal
D3, D4, D5, D6, D7, D8: 1N4148; D_DO-35_SOD27_P7.62mm_Horizontal
J1: RC2014_BUS; RC2014_PinHeader_Horizontal
J2: Page-out Address; PinHeader_2x08_P2.54mm_Vertical
J3: ROM Start/Size; PinHeader_2x04_P2.54mm_Vertical
J4: RAM Size; PinHeader_2x04_P2.54mm_Vertical
L1, L2: LED; LED_D3.0mm
R1, R2: 470R; R_Axial_DIN0207_L6.3mm_D2.5mm_P10.16mm_Horizontal
R3, R4, R5, R6: 10K; R_Axial_DIN0207_L6.3mm_D2.5mm_P10.16mm_Horizontal
RN2: 10K; R_Array_SIP9
SW1: STEP
U1: AT28C64; DIP_Socket-28_W11.9_W12.7_W15.24_W17.78_W18.5_3M_228-1277-0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
U2: 62256; DIP-28_W15.24mm_LongPads
U3: 74LS688; DIP-20_W7.62mm_LongPads
U4: 74LS74; DIP-14_W7.62mm_LongPads
U5: 74LS138; DIP-16_W7.62mm_LongPads
U6: 74LS00; DIP-14_W7.62mm_LongPads
U8: 74LS86; DIP-14_W7.62mm_LongPads

Connections:
+5V: C1.1, C2.1, C3.1, C5.2, C6.1, C7.1, D1.1 (K), D2.1 (K), J1.5V (Pin_18), J1.USR6 (Pin_78), J2.1, J2.3, J2.5, J2.7, J2.9, J2.11, J2.13, J2.15, R4.2, R5.1, U1.27 (~WE), U1.28 (VCC), U2.28 (VCC), U3.20 (VCC), U4.4 (1~PRE), U4.10 (2~PRE), U4.14 (VCC), U5.6 (E3), U5.16 (VCC), U6.14 (VCC), U8.14 (VCC)
A0: J1.A0 (Pin_16), U1.10 (A0), U2.10 (A0), U3.2 (P0)
A1: J1.A1 (Pin_15), U1.9 (A1), U2.9 (A1), U3.4 (P1)
A2: J1.A2 (Pin_14), U1.8 (A2), U2.8 (A2), U3.6 (P2)
A3: J1.A3 (Pin_13), U1.7 (A3), U2.7 (A3), U3.8 (P3)
A4: J1.A4 (Pin_12), U1.6 (A4), U2.6 (A4), U3.11 (P4)
A5: J1.A5 (Pin_11), U1.5 (A5), U2.5 (A5), U3.13 (P5)
A6: J1.A6 (Pin_10), U1.4 (A6), U2.4 (A6), U3.15 (P6)
A7: J1.A7 (Pin_9), U1.3 (A7), U2.3 (A7), U3.17 (P7)
A8: J1.A8 (Pin_8), U1.25 (A8), U2.25 (A8)
A9: J1.A9 (Pin_7), U1.24 (A9), U2.24 (A9)
A10: J1.A10 (Pin_6), U1.21 (A10), U2.21 (A10)
A11: D4.2 (A), J1.A11 (Pin_5), U1.23 (A11), U2.23 (A11)
A12: D5.2 (A), J1.A12 (Pin_4), U1.2 (A12), U2.2 (A12)
A13: D6.2 (A), J1.A13 (Pin_3), U1.26 (NC), U2.26 (A13), U5.1 (A0)
A14: D7.2 (A), J1.A14 (Pin_2), U1.1 (NC), U2.1 (A14), U5.2 (A1)
A15: D8.2 (A), J1.A15 (Pin_1), U5.3 (A2)
BS0: J1.BS0 (Pin_56), J4.7, U5.15 (O0)
BS1: J1.BS1 (Pin_55), J4.5, U5.14 (O1)
BS2: J1.BS2 (Pin_54), J4.3, U5.13 (O2)
BS3: J1.BS3 (Pin_53), J4.1, U5.12 (O3)
BS4: J1.BS4 (Pin_52), J3.7, U5.11 (O4)
BS5: J1.BS5 (Pin_51), J3.5, U5.10 (O5)
BS6: J1.BS6 (Pin_50), J3.3, U5.9 (O6)
BS7: J1.BS7 (Pin_49), J3.1, U5.7 (O7)
D0: J1.D0 (Pin_27), U1.11 (D0), U2.11 (D0), U4.2 (1D)
D1: J1.D1 (Pin_28), U1.12 (D1), U2.12 (D1)
D2: J1.D2 (Pin_29), U1.13 (D2), U2.13 (D2)
D3: J1.D3 (Pin_30), U1.15 (D3), U2.15 (D3)
D4: J1.D4 (Pin_31), U1.16 (D4), U2.16 (D4)
D5: J1.D5 (Pin_32), U1.17 (D5), U2.17 (D5)
D6: J1.D6 (Pin_33), U1.18 (D6), U2.18 (D6)
D7: J1.D7 (Pin_34), U1.19 (D7), U2.19 (D7)
GND: C1.2, C2.2, C3.2, C5.1, C6.2, C7.2, D1.2 (A), D2.2 (A), J1.GND (Pin_17), L1.1 (K), L2.1 (K), R3.2, R6.1, RN2.1 (common), U1.14 (GND), U2.14 (GND), U3.10 (GND), U4.7 (GND), U5.4 (E1), U5.8 (GND), U6.7 (GND), U8.7 (GND)
INT: U4.9 (2Q)
IORQ: J1.IORQ (Pin_26), U3.1 (G)
M1: U4.11 (2CLK)
MREQ: J1.MREQ (Pin_23), U5.5 (E2)
unnamed: D3.1 (K), D4.1 (K), D5.1 (K), D6.1 (K), D7.1 (K), D8.1 (K), R3.1, U6.9, U6.10
unnamed: D3.2 (A), U4.5 (1Q)
unnamed: J2.2, RN2.2 (R1), U3.18 (R7)
unnamed: J2.4, RN2.3 (R2), U3.16 (R6)
unnamed: J2.6, RN2.4 (R3), U3.14 (R5)
unnamed: J2.8, RN2.5 (R4), U3.12 (R4)
unnamed: J2.10, RN2.6 (R5), U3.9 (R3)
unnamed: J2.12, RN2.7 (R6), U3.7 (R2)
unnamed: J2.14, RN2.8 (R7), U3.5 (R1)
unnamed: J2.16, RN2.9 (R8), U3.3 (R0)
unnamed: L1.2 (A), R1.1
unnamed: L2.2 (A), R2.1
unnamed: R1.2, U4.8 (~2Q)
unnamed: R2.2, U4.6 (~1Q)
unnamed: R4.1, U8.2, U8.4
unnamed: R5.2, U8.5, U8.9
unnamed: R6.2, SW1.1 (A), U4.12 (2D)
unnamed: U1.20 (~CS), U6.6
unnamed: U2.20 (~CS), U6.3
unnamed: U3.19 (P=R), U4.3 (1CLK)
unnamed: U6.1, U8.3
unnamed: U6.2, U6.4, U8.6
unnamed: U6.5, U8.8
unnamed: U6.8, U8.1, U8.10
RD: J1.RD (Pin_25), U1.22 (~OE), U2.22 (~OE)
RESET: J1.RSET (Pin_20), U4.1 (1~CLR), U4.13 (2~CLR)
USR1: J1.USR1 (Pin_37)
WR: J1.WR (Pin_24), U2.27 (~WE)

Notes on the sheet:
TEC-2014 Memory
On RESET, Q=Lo
This FlipFlop used for Single Stepping through Code, triggering INT on each memory read cycle if the ROM is not selected. Use the switch to disable Stepper.
This line is asserted HIGH when the Memory Latch is Low, AND all the upper address lines are Low, meaning the CPU is addressing the lowest 2K range, which is where the TEC-1 ROMs were placed.
In this memory model, the ROM is placed in the upper end of the 64k addressable range, while the lower 32K is always reserved for RAM. J3 lets the user control what size (in 8k blocks) the ROM is and at what address range it is to start at. For example, if the user has a 16k ROM, that they wish to 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
The ROM is selected (asserted LOW) IF { 1) The Shadow Latch is Low (on reset) AND 2) Any address in the lower 2K is requested } OR 3) If an address is within the range determined by J3 OTHERWISE The RAM bank on this card is selected if it falls within the address range determined by J4, but must st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
ROM Select
RAM Select
on = ROM Shadowed
To remove the Shadowed ROM, an OUTput of $00 to the Port specified by the jumpers Flips the Flop off and removes the ROM from lower 2K. (It is possible to Shadow it back in with an OUTput of $01)
