MarkJelic/TEC-2014/SBC/TEC-2014s.sch

## KiCad design SBC/TEC-2014s.sch (2021-07-12)

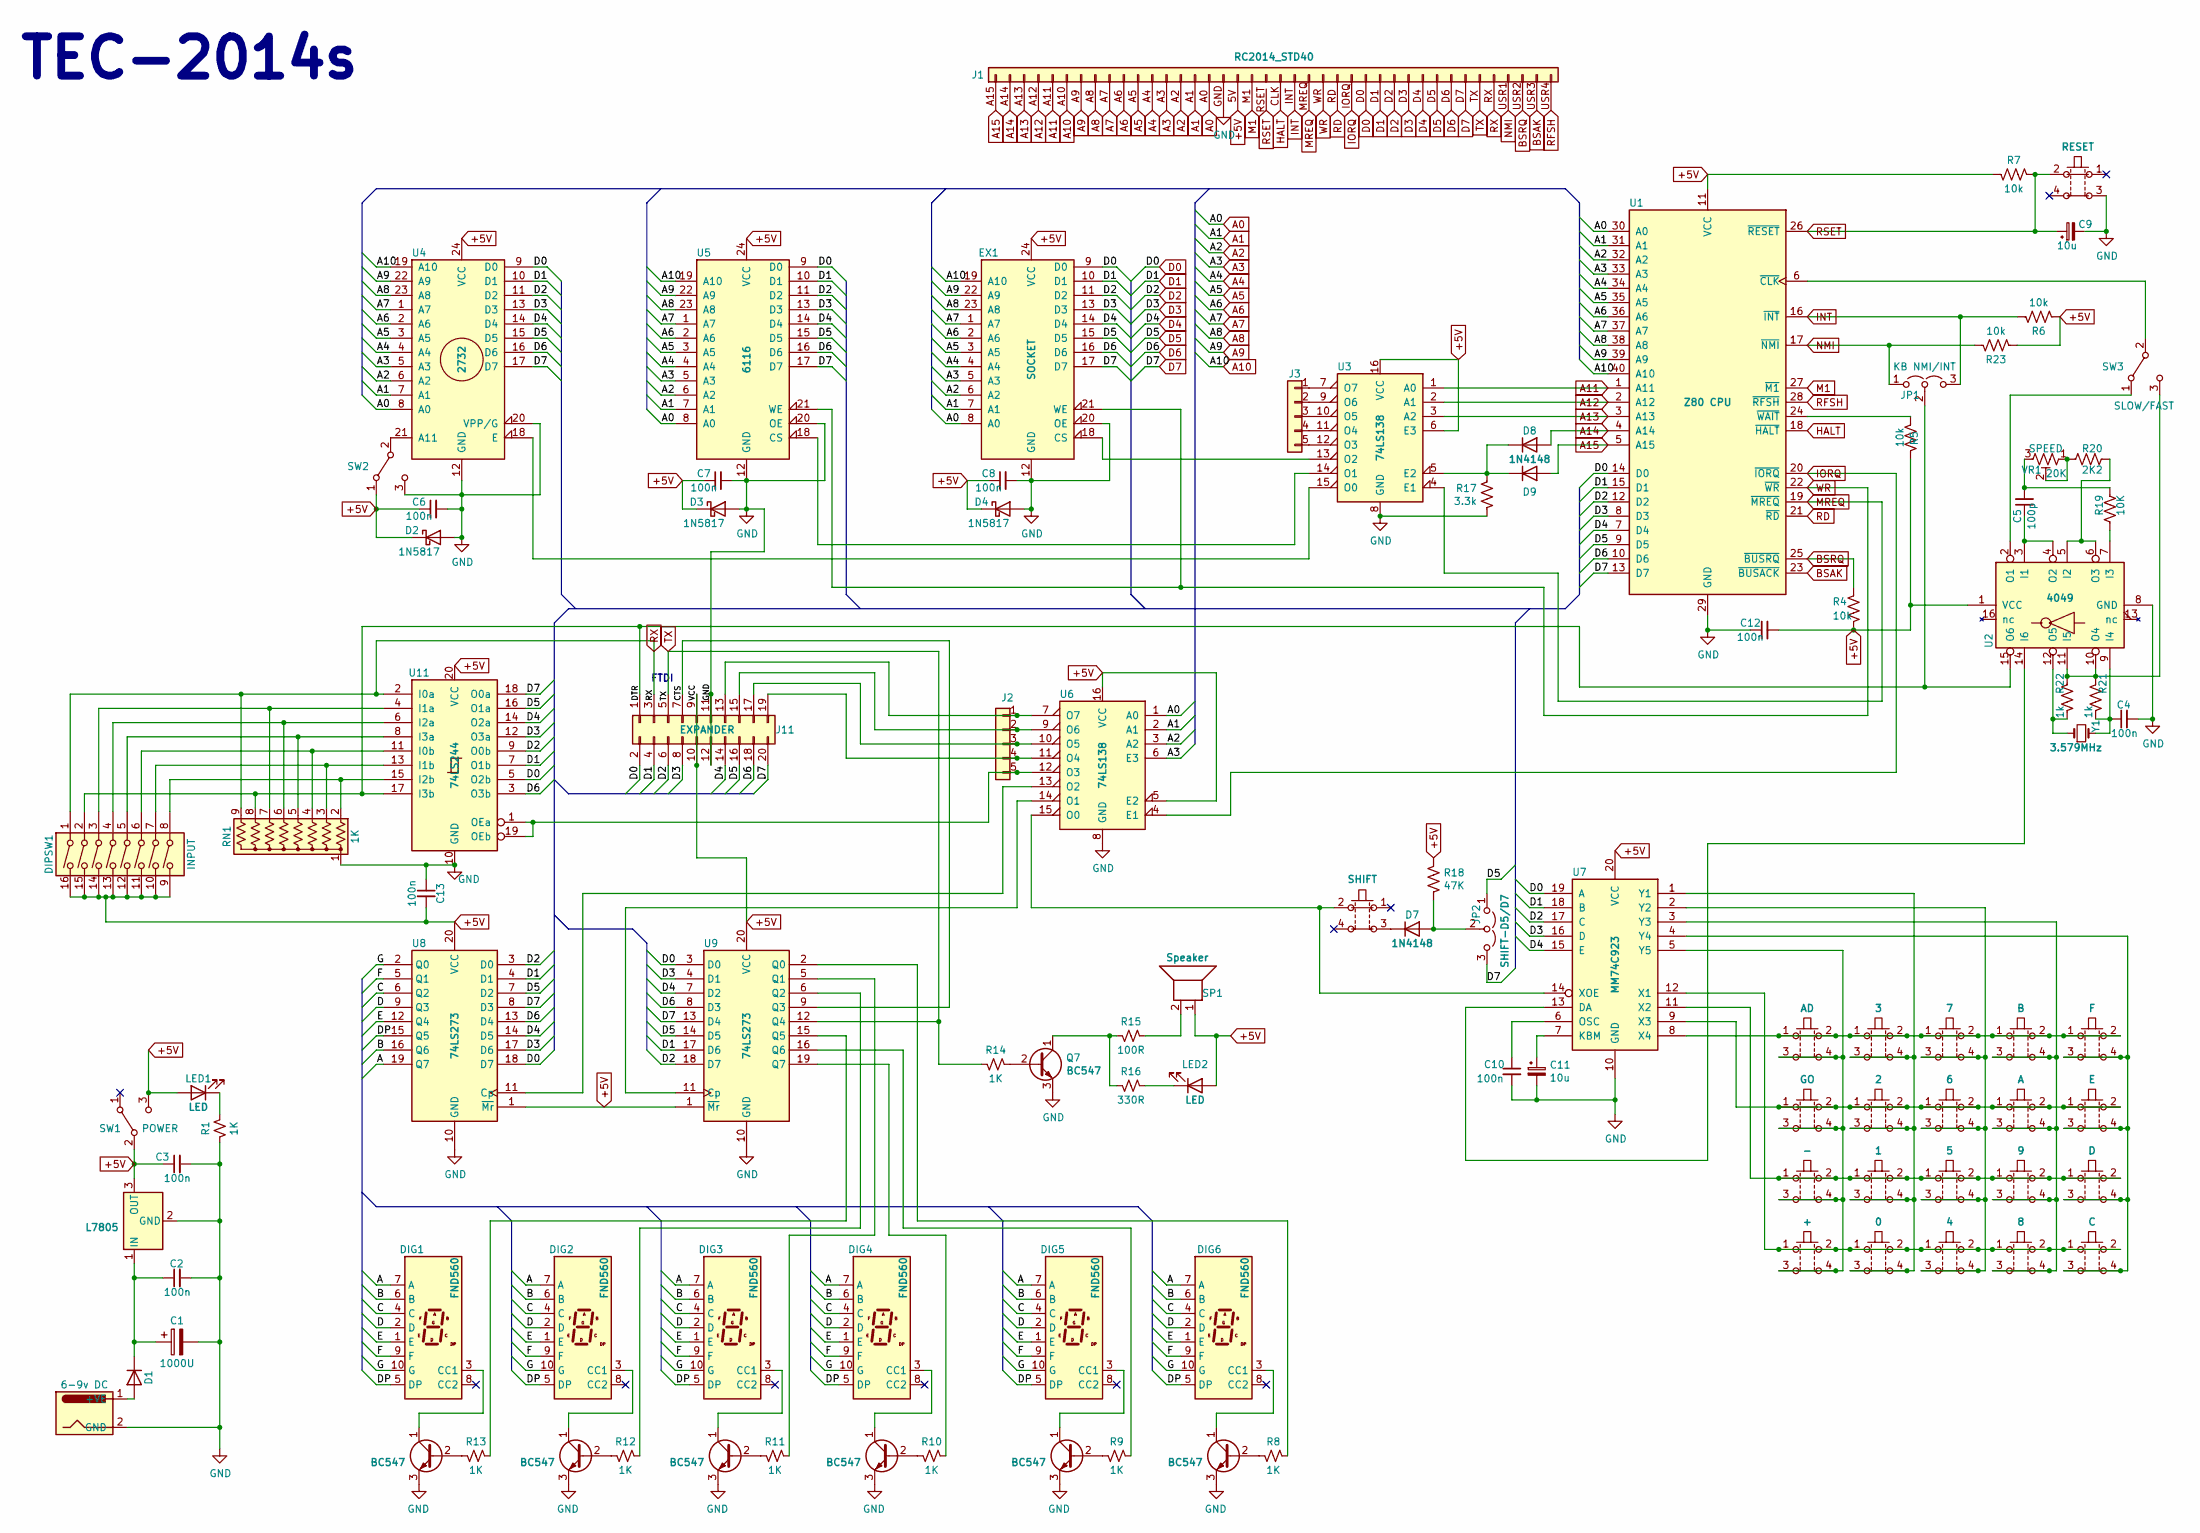
[picture p9: schematic TEC-2014s.sch]

Parts:
C1: 1000U; CP_Radial_D10.0mm_P5.00mm
C2, C3, C4, C6, C7, C8, C10, C12, C13: 100n; C_Disc_D6.0mm_W2.5mm_P5.00mm
C5: 100p; C_Disc_D6.0mm_W2.5mm_P5.00mm
C9, C11: 10u; CP_Radial_D5.0mm_P2.50mm
D1: 1N4002; D_DO-41_SOD81_P10.16mm_Horizontal
D2, D3, D4: 1N5817; D_DO-41_SOD81_P22mm_Horizontal
D7, D8, D9: 1N4148; D_DO-35_SOD27_P7.62mm_Horizontal
DIG1, DIG2, DIG3, DIG4, DIG5, DIG6: FND560; 7SegmentLED_LTS6760_LTS6780
DIPSW1: INPUT; SW_DIP_SPSTx08_Slide_9.78x22.5mm_W7.62mm_P2.54mm
EX1: SOCKET; DIP_Socket-24_W11.9_W12.7_W15.24_W17.78_W18.5_3M_224-1275-0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
J1: RC2014_STD40; PinHeader_1x40_P2.54mm_Vertical
J2: IO; PinSocket_1x05_P2.54mm_Vertical
J3: MEM; PinSocket_1x05_P2.54mm_Vertical
J11: EXPANDER; PinSocket_2x10_P2.54mm_Vertical
JP1: KB NMI/INT; PinHeader_1x03_P2.54mm_Vertical
JP2: SHIFT-D5/D7; PinHeader_1x03_P2.54mm_Vertical
KEY1: +; SW_Keyboard
KEY2: -; SW_Keyboard
KEY3: GO; SW_Keyboard
KEY4: AD; SW_Keyboard
KEY5: 0; SW_Keyboard
KEY6: 1; SW_Keyboard
KEY7: 2; SW_Keyboard
KEY8: 3; SW_Keyboard
KEY9: 4; SW_Keyboard
KEY10: 5; SW_Keyboard
KEY11: 6; SW_Keyboard
KEY12: 7; SW_Keyboard
KEY13: 8; SW_Keyboard
KEY14: 9; SW_Keyboard
KEY15: A; SW_Keyboard
KEY16: B; SW_Keyboard
KEY17: C; SW_Keyboard
KEY18: D; SW_Keyboard
KEY19: E; SW_Keyboard
KEY20: F; SW_Keyboard
KEY21: RESET; SW_Keyboard
KEY22: SHIFT; SW_Keyboard
LED1, LED2: LED; LED_D5.0mm
Q0, Q1, Q2, Q3, Q4, Q5, Q7: BC547; TO-92L_Wide
R1, R8, R9, R10, R11, R12, R13, R14: 1K; R_Axial_DIN0309_L9.0mm_D3.2mm_P12.70mm_Horizontal
R4, R5, R6, R7, R23: 10k; R_Axial_DIN0309_L9.0mm_D3.2mm_P12.70mm_Horizontal
R15: 100R; R_Axial_DIN0309_L9.0mm_D3.2mm_P12.70mm_Horizontal
R16: 330R; R_Axial_DIN0309_L9.0mm_D3.2mm_P12.70mm_Horizontal
R17: 3.3k; R_Axial_DIN0309_L9.0mm_D3.2mm_P12.70mm_Horizontal
R18: 47K; R_Axial_DIN0309_L9.0mm_D3.2mm_P12.70mm_Horizontal
R19: 10K; R_Axial_DIN0309_L9.0mm_D3.2mm_P12.70mm_Horizontal
R20: 2K2; R_Axial_DIN0309_L9.0mm_D3.2mm_P12.70mm_Horizontal
R21, R22: 1k; R_Axial_DIN0309_L9.0mm_D3.2mm_P12.70mm_Horizontal
REG2: L7805; 7805_Horizontal_TabDwn
RN1: 1K; R_Array_SIP9
SKT1: 6-9v DC; BarrelJack_Horizontal
SP1: Speaker; MagneticBuzzer_ProSignal_ABI-010-RC
SW1: POWER; SW_Slide
SW2: SW_SPDT; SW_Slide
SW3: SLOW/FAST; SW_Slide
U1: Z80 CPU; DIP-40_W15.24mm_LongPads
U2: 4049; DIP-16_W7.62mm_LongPads
U3, U6: 74LS138; DIP-16_W7.62mm_LongPads
U4: 2732; DIP-24_W15.24mm_LongPads
U5: 6116; DIP-24_W15.24mm_LongPads
U7: MM74C923; DIP-20_W7.62mm_LongPads
U8, U9: 74LS273; DIP-20_W7.62mm_LongPads
U11: 74LS244; DIP-20_W7.62mm_LongPads
VR1: 20K; Potentiometer_Vishay_T7-YA_Single_Vertical
Y1: 3.579MHz; Crystal_HC49-4H_Vertical

Connections:
+5V: C3.1, C6.1, C7.1, C8.1, C12.2, C13.2, D2.1 (K), D3.1 (K), D4.1 (K), DIPSW1.9, DIPSW1.10, DIPSW1.11, DIPSW1.12, DIPSW1.13, DIPSW1.14, DIPSW1.15, DIPSW1.16, EX1.24 (VCC), J1.5V (Pin_18), J11.9, J11.10, LED1.2 (A), LED2.2 (A), R4.2, R5.2, R6.2, R7.2, R18.1, R23.2, REG2.3 (OUT), SP1.1, SW1.2 (B), SW1.3 (C), SW2.1 (A), U1.11 (VCC), U2.1 (VCC), U3.6 (E3), U3.16 (VCC), U4.24 (VCC), U5.24 (VCC), U6.5 (E2), U6.16 (VCC), U7.20 (VCC), U8.1 (~Mr), U8.20 (VCC), U9.1 (~Mr), U9.20 (VCC), U11.20 (VCC)
A: DIG1.7 (A), DIG2.7 (A), DIG3.7 (A), DIG4.7 (A), DIG5.7 (A), DIG6.7 (A), U8.19 (Q7)
A0: EX1.8 (A0), J1.A0 (Pin_16), U1.30 (A0), U4.8 (A0), U5.8 (A0), U6.1 (A0)
A1: EX1.7 (A1), J1.A1 (Pin_15), U1.31 (A1), U4.7 (A1), U5.7 (A1), U6.2 (A1)
A2: EX1.6 (A2), J1.A2 (Pin_14), U1.32 (A2), U4.6 (A2), U5.6 (A2), U6.3 (A2)
A3: EX1.5 (A3), J1.A3 (Pin_13), U1.33 (A3), U4.5 (A3), U5.5 (A3), U6.6 (E3)
A4: EX1.4 (A4), J1.A4 (Pin_12), U1.34 (A4), U4.4 (A4), U5.4 (A4)
A5: EX1.3 (A5), J1.A5 (Pin_11), U1.35 (A5), U4.3 (A5), U5.3 (A5)
A6: EX1.2 (A6), J1.A6 (Pin_10), U1.36 (A6), U4.2 (A6), U5.2 (A6)
A7: EX1.1 (A7), J1.A7 (Pin_9), U1.37 (A7), U4.1 (A7), U5.1 (A7)
A8: EX1.23 (A8), J1.A8 (Pin_8), U1.38 (A8), U4.23 (A8), U5.23 (A8)
A9: EX1.22 (A9), J1.A9 (Pin_7), U1.39 (A9), U4.22 (A9), U5.22 (A9)
A10: EX1.19 (A10), J1.A10 (Pin_6), U1.40 (A10), U4.19 (A10), U5.19 (A10)
A11: J1.A11 (Pin_5), U1.1 (A11), U3.1 (A0)
A12: J1.A12 (Pin_4), U1.2 (A12), U3.2 (A1)
A13: J1.A13 (Pin_3), U1.3 (A13), U3.3 (A2)
A14: D8.2 (A), J1.A14 (Pin_2), U1.4 (A14)
A15: D9.2 (A), J1.A15 (Pin_1), U1.5 (A15)
B: DIG1.6 (B), DIG2.6 (B), DIG3.6 (B), DIG4.6 (B), DIG5.6 (B), DIG6.6 (B), U8.16 (Q6)
BSAK: J1.USR3 (Pin_39), U1.23 (~BUSACK~)
BSRQ: J1.USR2 (Pin_38), R4.1, U1.25 (~BUSRQ~)
C: DIG1.4 (C), DIG2.4 (C), DIG3.4 (C), DIG4.4 (C), DIG5.4 (C), DIG6.4 (C), U8.6 (Q2)
D: DIG1.2 (D), DIG2.2 (D), DIG3.2 (D), DIG4.2 (D), DIG5.2 (D), DIG6.2 (D), U8.9 (Q3)
D0: EX1.9 (D0), J1.D0 (Pin_27), J11.2, U1.14 (D0), U4.9 (D0), U5.9 (D0), U7.19 (A), U8.18 (D7), U9.3 (D0), U11.5 (O2b)
D1: EX1.10 (D1), J1.D1 (Pin_28), J11.4, U1.15 (D1), U4.10 (D1), U5.10 (D1), U7.18 (B), U8.4 (D1), U9.17 (D6), U11.7 (O1b)
D2: EX1.11 (D2), J1.D2 (Pin_29), J11.6, U1.12 (D2), U4.11 (D2), U5.11 (D2), U7.17 (C), U8.3 (D0), U9.18 (D7), U11.9 (O0b)
D3: EX1.13 (D3), J1.D3 (Pin_30), J11.8, U1.8 (D3), U4.13 (D3), U5.13 (D3), U7.16 (D), U8.17 (D6), U9.4 (D1), U11.12 (O3a)
D4: EX1.14 (D4), J1.D4 (Pin_31), J11.14, U1.7 (D4), U4.14 (D4), U5.14 (D4), U7.15 (E), U8.14 (D5), U9.7 (D2), U11.14 (O2a)
D5: EX1.15 (D5), J1.D5 (Pin_32), J11.16, JP2.1 (A), U1.9 (D5), U4.15 (D5), U5.15 (D5), U8.7 (D2), U9.14 (D5), U11.16 (O1a)
D6: EX1.16 (D6), J1.D6 (Pin_33), J11.18, U1.10 (D6), U4.16 (D6), U5.16 (D6), U8.13 (D4), U9.8 (D3), U11.3 (O3b)
D7: EX1.17 (D7), J1.D7 (Pin_34), J11.20, JP2.3 (B), U1.13 (D7), U4.17 (D7), U5.17 (D7), U8.8 (D3), U9.13 (D4), U11.18 (O0a)
DP: DIG1.5 (DP), DIG2.5 (DP), DIG3.5 (DP), DIG4.5 (DP), DIG5.5 (DP), DIG6.5 (DP), U8.15 (Q5)
E: DIG1.1 (E), DIG2.1 (E), DIG3.1 (E), DIG4.1 (E), DIG5.1 (E), DIG6.1 (E), U8.12 (Q4)
F: DIG1.9 (F), DIG2.9 (F), DIG3.9 (F), DIG4.9 (F), DIG5.9 (F), DIG6.9 (F), U8.5 (Q1)
G: DIG1.10 (G), DIG2.10 (G), DIG3.10 (G), DIG4.10 (G), DIG5.10 (G), DIG6.10 (G), U8.2 (Q0)
GND: C1.2, C2.2, C3.2, C4.2, C6.2, C7.2, C8.2, C9.2, C10.2, C11.2, C12.1, C13.1, D2.2 (A), D3.2 (A), D4.2 (A), EX1.12 (GND), EX1.20 (OE), J1.GND (Pin_17), J11.11, J11.12, KEY21.3, Q0.3 (E), Q1.3 (E), Q2.3 (E), Q3.3 (E), Q4.3 (E), Q5.3 (E), Q7.3 (E), R1.2, R17.1, REG2.2 (GND), RN1.1 (common), SKT1.2 (GND), SW2.3 (C), U1.29 (GND), U2.8 (GND), U3.8 (GND), U4.12 (GND), U4.20 (VPP/G), U5.12 (GND), U5.20 (OE), U6.8 (GND), U7.10 (GND), U8.10 (GND), U9.10 (GND), U11.10 (GND)
HALT: J1.CLK (Pin_21), U1.18 (~HALT~)
INT: J1.INT (Pin_22), JP1.3 (B), R6.1, U1.16 (~INT~)
IORQ: J1.IORQ (Pin_26), U1.20 (~IORQ~), U6.4 (E1)
M1: J1.M1 (Pin_19), U1.27 (~M1~)
MREQ: J1.MREQ (Pin_23), U1.19 (~MREQ~), U3.4 (E1)
NMI: J1.USR1 (Pin_37), JP1.1 (A), R23.1, U1.17 (~NMI~)
unnamed: C1.1, C2.1, D1.1 (K), REG2.1 (IN)
unnamed: C4.1, R21.1, U2.9 (I4), Y1.2
unnamed: C5.1, U2.3 (I1), U2.4 (O2)
unnamed: C5.2, R19.2, VR1.3
unnamed: C10.1, U7.6 (OSC)
unnamed: C11.1, U7.7 (KBM)
unnamed: D1.2 (A), SKT1.1 (+VE)
unnamed: D7.1 (K), KEY22.3
unnamed: D7.2 (A), JP2.2 (C), R18.2
unnamed: D8.1 (K), D9.1 (K), R17.2, U3.5 (E2)
unnamed: DIG1.3 (CC1), Q5.1 (C)
unnamed: DIG2.3 (CC1), Q4.1 (C)
unnamed: DIG3.3 (CC1), Q3.1 (C)
unnamed: DIG4.3 (CC1), Q2.1 (C)
unnamed: DIG5.3 (CC1), Q1.1 (C)
unnamed: DIG6.3 (CC1), Q0.1 (C)
unnamed: DIPSW1.2, J11.1, JP1.2 (C), RN1.8 (R7), U2.15 (O6), U11.17 (I3b)
unnamed: DIPSW1.3, RN1.7 (R6), U11.4 (I1a)
unnamed: DIPSW1.4, RN1.6 (R5), U11.6 (I2a)
unnamed: DIPSW1.5, RN1.5 (R4), U11.8 (I3a)
unnamed: DIPSW1.6, RN1.4 (R3), U11.11 (I0b)
unnamed: DIPSW1.7, RN1.3 (R2), U11.13 (I1b)
unnamed: DIPSW1.8, RN1.2 (R1), U11.15 (I2b)
unnamed: EX1.18 (CS), U3.13 (O2)
unnamed: J2.5, U6.12 (O3), U11.1 (OEa), U11.19 (OEb)
unnamed: J3.1, U3.7 (O7)
unnamed: J3.2, U3.9 (O6)
unnamed: J3.3, U3.10 (O5)
unnamed: J3.4, U3.11 (O4)
unnamed: J3.5, U3.12 (O3)
unnamed: J11.7, U9.9 (Q3)
unnamed: J2.1, J11.13, U6.7 (O7)
unnamed: J2.2, J11.15, U6.9 (O6)
unnamed: J2.3, J11.17, U6.10 (O5)
unnamed: J2.4, J11.19, U6.11 (O4)
unnamed: KEY1.1, KEY1.2, KEY5.1, KEY5.2, KEY9.1, KEY9.2, KEY13.1, KEY13.2, KEY17.1, KEY17.2, U7.12 (X1)
unnamed: KEY1.3, KEY1.4, KEY2.3, KEY2.4, KEY3.3, KEY3.4, KEY4.3, KEY4.4, U7.5 (Y5)
unnamed: KEY5.3, KEY5.4, KEY6.3, KEY6.4, KEY7.3, KEY7.4, KEY8.3, KEY8.4, U7.1 (Y1)
unnamed: KEY2.1, KEY2.2, KEY6.1, KEY6.2, KEY10.1, KEY10.2, KEY14.1, KEY14.2, KEY18.1, KEY18.2, U7.11 (X2)
unnamed: KEY9.3, KEY9.4, KEY10.3, KEY10.4, KEY11.3, KEY11.4, KEY12.3, KEY12.4, U7.2 (Y2)
unnamed: KEY3.1, KEY3.2, KEY7.1, KEY7.2, KEY11.1, KEY11.2, KEY15.1, KEY15.2, KEY19.1, KEY19.2, U7.9 (X3)
unnamed: KEY4.1, KEY4.2, KEY8.1, KEY8.2, KEY12.1, KEY12.2, KEY16.1, KEY16.2, KEY20.1, KEY20.2, U7.8 (X4)
unnamed: KEY13.3, KEY13.4, KEY14.3, KEY14.4, KEY15.3, KEY15.4, KEY16.3, KEY16.4, U7.3 (Y3)
unnamed: KEY17.3, KEY17.4, KEY18.3, KEY18.4, KEY19.3, KEY19.4, KEY20.3, KEY20.4, U7.4 (Y4)
unnamed: KEY22.2, U6.15 (O0), U7.14 (XOE)
unnamed: LED1.1 (K), R1.1
unnamed: LED2.1 (K), R16.1
unnamed: Q0.2 (B), R8.2
unnamed: Q1.2 (B), R9.2
unnamed: Q2.2 (B), R10.2
unnamed: Q3.2 (B), R11.2
unnamed: Q4.2 (B), R12.2
unnamed: Q5.2 (B), R13.2
unnamed: Q7.1 (C), R15.2, R16.2
unnamed: Q7.2 (B), R14.1
unnamed: R5.1, U1.24 (~WAIT~)
unnamed: R8.1, U9.2 (Q0)
unnamed: R9.1, U9.16 (Q6)
unnamed: R10.1, U9.19 (Q7)
unnamed: R11.1, U9.5 (Q1)
unnamed: R12.1, U9.6 (Q2)
unnamed: R13.1, U9.15 (Q5)
unnamed: R15.1, SP1.2
unnamed: R19.1, U2.7 (I3)
unnamed: R20.1, VR1.1, VR1.2
unnamed: R20.2, U2.5 (I2), U2.6 (O3)
unnamed: R21.2, R22.2, SW3.3 (C), U2.10 (O4), U2.11 (I5)
unnamed: R22.1, U2.12 (O5), Y1.1
unnamed: SW2.2 (B), U4.21 (A11)
unnamed: SW3.1 (A), U2.2 (O1)
unnamed: SW3.2 (B), U1.6 (~CLK~)
unnamed: U2.14 (I6), U7.13 (DA)
unnamed: U3.14 (O1), U5.18 (CS)
unnamed: U3.15 (O0), U4.18 (E)
unnamed: U6.13 (O2), U8.11 (Cp)
unnamed: U6.14 (O1), U9.11 (Cp)
RD: J1.RD (Pin_25), U1.21 (~RD~)
RFSH: J1.USR4 (Pin_40), U1.28 (~RFSH~)
RSET: C9.1, J1.RSET (Pin_20), KEY21.2, R7.1, U1.26 (~RESET~)
RX: DIPSW1.1, J1.RX (Pin_36), J11.3, RN1.9 (R8), U11.2 (I0a)
TX: J1.TX (Pin_35), J11.5, R14.2, U9.12 (Q4)
WR: EX1.21 (WE), J1.WR (Pin_24), U1.22 (~WR~), U5.21 (WE)

Notes on the sheet:
FTDI
TEC-2014s
