MarkJelic/TEC-2014/(commit log)

2021-02-07 TEC-2014 design files.
    Schematic and 3D render of the TEC-2104 Display card
2021-06-25 Update README.md
    Included a render of the board and updated the description for the Latched pins going to D8 - D15
2021-06-25 Updated Schematic PDF
    Routed the Latched output of the Digits driver to the D8 to D15 pins on the bus
2021-06-25 Updated Schematic
    Routed latched lines of the Digit driver to D8-D15 lines on the RC-2014 bus. These can be used to drive MAX7219 matrix LEDs or used for BitBang serial
2021-06-25 KiCad Project Files
    KiCAD Project, Library and Schematic.
    [RC2014-TECdisplay v2.sch]
2021-06-25 Update README.md
    Included screenshot of the PCB layout.
2021-07-03 Updated Schematic in PDF format
2021-07-20 Shadow ROM Memory Select Circuit Tester
    This text file can be loaded into the online circuit tester to see if the logic works as intended.
2021-07-20 Using the Circuit Tester
    Added instructions on how to use the circuit tester.
2021-07-20 Replacing files
    that I didn't think I deleted.
    [RC2014-TECmemory.sch]
